henkjannl/GPS/05 Electrical/Wiring diagram 07 - MH-ET Live Minikit.jpg

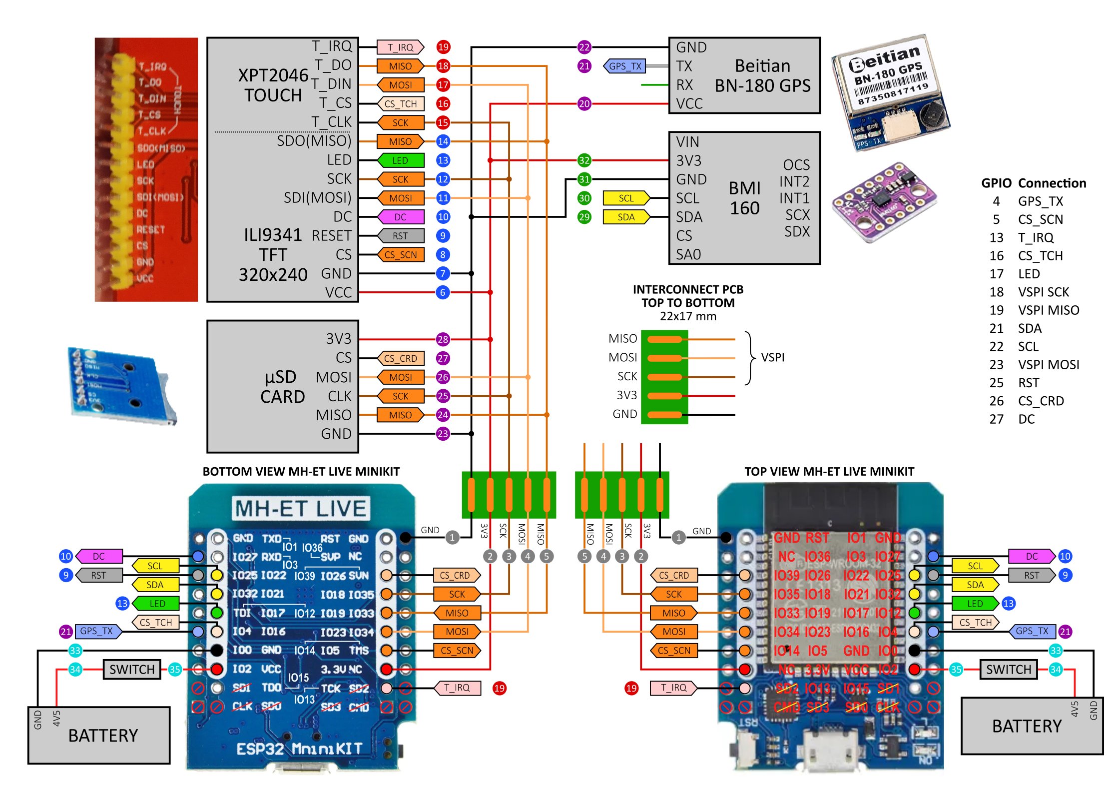
05 Electrical/Wiring diagram 07 - MH-ET Live Minikit.jpg
