henkjannl/GPS/03 Map/Kaartprojectie/Kaartprojectie.odt

# Meest nauwkeurige oplossing met kromming

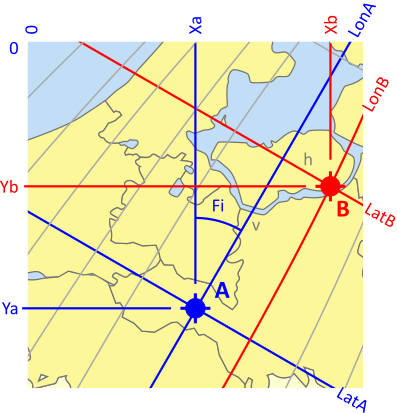
[picture p4: figure]

Punt A is de huidige positie op de kaart, behorend bij pixelpositie (xa,ya) op het scherm. De kaart moet met een hoek Fi worden verdraaid.

De omtrek van de aarde bij de parallel op latitude LatB is bij benadering:

O_{LatB}=O cdot cos(LatB) = 40 cdot 10 ^ 6 cdot cos(LatB) ~ [m]

De horizontale afstand h op het aardoppervlak is:

h_world = 40 cdot 10 ^ 6 cdot cos(LatB) cdot { {LonB-LonA} over {360}} ~ [m]

De omtrek op iedere meridiaan is bij benadering 40·10⁶ m. De vertikale afstand v op het aardoppervlak is dus:

v_world = 40 cdot 10 ^ 6 cdot { {LatB-LatA} over {360}} ~ [m]

Vaak wordt de afstand op het scherm weeregeven als een balkje dat een bepaalde lengte in werkelijkheid voorstelt. Stel een bepaalde afstand x in de werkelijke wereld correspondeert met een aantal pixels n op het scherm, dan is de schaalfactor s:

s = { n over x} ~ left [ {pixels over m} right ]

De lengte van h en v op het scherm is:

matrix{
alignl h_screen # alignl` = s cdot 40 cdot 10 ^ 6 cdot cos(LatB) cdot { alignc {LonB-LonA} over {360}} # [ pixels ] ##
alignl v_screen # alignl` = s cdot 40 cdot 10 ^ 6 cdot { alignc {LatB-LatA} over {360}} # [ pixels ] }

De schermcoördinaten van punt B zijn:

matrix{ X_B # ` = ` # X_A # `+` # v cdot sin ( Fi ) # `+` # h cdot cos ( Fi ) ##
Y_B # `=` # Y_A # `-` # v cdot cos(Fi ) # `+` # h cdot sin( Fi )

}

We definiëren hulpvariabele S:

S={alignc 40 cdot 10 ^ 6 } over {alignc 360 } cdot s {alignc 40 cdot 10 ^ 6 cdot n } over {alignc 360 cdot x }

Waarmee we de schermcoördinaten kunnen uitschrijven tot:

alignl matrix{
X_B # ` = ` # X_A # `+` # alignl S cdot lbrace { `+ (LatB-LatA) cdot sin ( Fi ) + ( alignc {LonB-LonA} )cdot cos(LatB) cdot cos ( Fi )} rbrace ##
Y_B # `=` # Y_A # `+` # alignl S cdot [ -(LatB-LatA) cdot cos(Fi ) + ( alignc {LonB-LonA} )cdot cos(LatB) cdot sin( Fi ) ]
}

We introduceren twee nieuwe hulpvariabelen:

matrix {
P # `=` # S cdot sin(Fi) # `=` # {alignc 40 cdot 10 ^ 6 cdot n} over {alignc 360 cdot x } cdot sin(Fi) ##
Q # `=` # S cdot cos(Fi) # `=` # {alignc 40 cdot 10 ^ 6 cdot n} over {alignc 360 cdot x } cdot cos(Fi)
}

Als LonB en LatB en cos(LatB) de enige variabelen over een puntenwolk zijn, dan kan dit worden omgeschreven tot:

alignl matrix{
X_B # ` = ` # X_A + S cdot sin(Fi) cdot (LatB-LatA) + S cdot cos(Fi) cdot (LonB-LonA) cdot cos(LatB) ##
X_B # ` = ` # X_A + P cdot (LatB-LatA) + Q cdot (LonB-LonA) cdot cos(LatB) ##
X_B # ` = ` # X_A + P cdot LatB- P cdot LatA + Q cdot LonB cdot cos(LatB) - Q cdot LonA cdot cos(LatB) ##
X_B # ` = ` # (X_A - P cdot LatA) + P cdot LatB - (Q cdot LonA) cdot cos(LatB)+ Q cdot LonB cdot cos(LatB) }

en:

alignl matrix{
Y_B # `=` # Y_A - S cdot cos(Fi) cdot (LatB-LatA) + S cdot sin(Fi) cdot (LonB-LonA ) cdot cos(LatB) ##
Y_B # `=` # Y_A - Q cdot (LatB-LatA) + P cdot (LonB-LonA ) cdot cos(LatB) ##
Y_B # `=` # Y_A - Q cdot LatB+ Q cdot LatA + P cdot LonB cdot cos(LatB) - P cdot LonA cdot cos(LatB) ##
Y_B # `=` # (Y_A + Q cdot LatA) - Q cdot LatB - (P cdot LonA) cdot cos(LatB)+ P cdot LonB cdot cos(LatB) }

In matrixnotatie:

left lbrace matrix { X_B ## Y_B } right rbrace =
left [
matrix {
X_A-P cdot LatA # P # -Q cdot LonA # Q ##
Y_A+Q cdot LatA # -Q # -P cdot LonA # P
}
right ] cdot
left lbrace matrix {
1 ##
LatB ##
cos(LatB) ##
LonB cdot cos(LatB) } right rbrace

# Vereenvoudigde oplossing zonder kruistermen

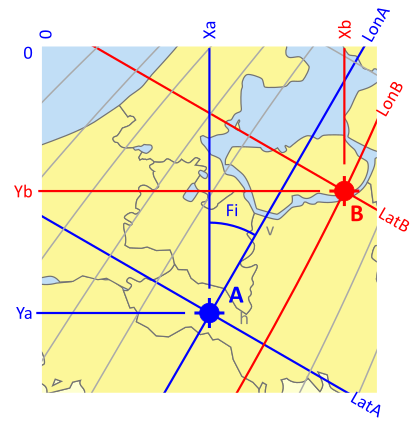
[picture p5: figure]

De horizontale afstand h op het aardoppervlak meten we hier bij punt A, zodat kruistermen worden voorkomen:

h_world = 40 cdot 10 ^ 6 cdot cos(LatA) cdot { {LonB-LonA} over {360}} ~ [m]

Bij deze benadering lopen de meridianen in de projectie dus parallel aan elkaar.

De vertikale afstand v op het aardoppervlak is ook hier:

v_world = 40 cdot 10 ^ 6 cdot { {LatB-LatA} over {360}} ~ [m]

De lengte van h en v op het scherm is:

matrix{
alignl h_screen # alignl` = s cdot 40 cdot 10 ^ 6 cdot cos(LatA) cdot { alignc {LonB-LonA} over {360}} # [ m] ##
alignl v_screen # alignl` = s cdot 40 cdot 10 ^ 6 cdot { alignc {LatB-LatA} over {360}} # [ m] }

Dezelfde afstanden gemeten in pixels:

matrix{
alignl h_pixels # alignl` = {alignc 40 cdot 10 ^ 6 cdot s} over {alignc 360 cdot m } cdot ( alignc {LonB-LonA} )cdot cos(LatA) # [ pixels ] ##
alignl v_pixels # alignl` = {alignc 40 cdot 10 ^ 6 cdot s} over {alignc 360 cdot m } cdot (LatB-LatA) # [ pixels ] }

De schermcoördinaten van punt B zijn:

matrix{ X_B # ` = ` # X_A # `+` # v cdot sin ( Fi ) # `+` # h cdot cos ( Fi ) ##
Y_B # `=` # Y_A # `-` # v cdot cos(Fi ) # `+` # h cdot sin( Fi )

}

We definiëren hulpvariabele S:

S={alignc 40 cdot 10 ^ 6 } over {alignc 360 } cdot s

Waarmee we de schermcoördinaten kunnen uitschrijven tot:

alignl matrix{
X_B # ` = ` # X_A # `+` # alignl S cdot lbrace { `+ (LatB-LatA) cdot sin ( Fi ) + ( alignc {LonB-LonA} )cdot cos(LatA) cdot cos ( Fi )} rbrace ##
Y_B # `=` # Y_A # `+` # alignl S cdot lbrace -(LatB-LatA) cdot cos(Fi ) + ( alignc {LonB-LonA} )cdot cos(LatA) cdot sin( Fi ) rbrace
}

We introduceren twee nieuwe hulpvariabelen:

matrix {
P # `=` # S cdot sin(Fi) # `=` # {alignc 40 cdot 10 ^ 6 cdot s} over {alignc 360 } cdot sin(Fi) ##
Q # `=` # S cdot cos(Fi) # `=` # {alignc 40 cdot 10 ^ 6 cdot s} over {alignc 360 } cdot cos(Fi)
}

Daarmee laten de schermcoördinaten zich omschrijven tot:

alignl matrix{
X_B # ` = ` # X_A + S cdot sin(Fi) cdot(LatB-LatA) + S cdot cos(Fi) cdot cos(LatA) cdot (LonB-LonA) ##
X_B # ` = ` # X_A + P cdot(LatB-LatA) + Q cdot cos(LatA) cdot (LonB-LonA) ##
X_B # ` = ` # [X_A - P cdot LatA - Q cdot cos(LatA) cdot LonA ]+ [P] cdot LatB + [Q cdot cos(LatA)] cdot LonB
}

alignl matrix{
Y_B # `=` # Y_A -S cdot cos(Fi) cdot(LatB-LatA) + S cdot sin(Fi) cdot cos(LatA) cdot(LonB-LonA) ##
Y_B # `=` # Y_A -Q cdot(LatB-LatA) + P cdot cos(LatA) cdot(LonB-LonA) ##
Y_B # `=` # [Y_A+Q cdot LatA- P cdot cos(LatA) cdot LonA] -Q cdot LatB + [P cdot cos(LatA)] cdot LonB

}

Oftewel:

left lbrace matrix { X_B ## Y_B } right rbrace =
left [ matrix{
X_A - P cdot LatA - Q cdot cos(LatA) cdot LonA #
Y_A + Q cdot LatA - P cdot cos(LatA) cdot LonA
##
P # -Q ##
Q cdot cos(LatA) # P cdot cos(LatA)
}
right ]
cdot left lbrace matrix { 1 ## LatB ## LonB } right rbrace

left lbrace matrix { c_1 ## c_2 ## c_3 ## c_4 ## c_5 ## c_6 } right rbrace =
left lbrace matrix { X_A - P cdot LatA - Q cdot cos(LatA) cdot LonA ##
P ##
Q cdot cos(LatA) ##
Y_A + Q cdot LatA - P cdot cos(LatA) cdot LonA ##
-Q ##
P cdot cos(LatA)
} right rbrace

left lbrace matrix { X_B ## Y_B } right rbrace =
left lbrace matrix {
c_1 + c_2 cdot LatB + c_3 cdot LonB ##
c_4 + c_5 cdot LatB + c_6 cdot LonB
} right rbrace

class MapProjection {

public:

MapProjection();

void setCenterPointOnMap(double lon, double lat);

void setCenterOnScreen(int x, int y);

void setRotation(doulbe rotation);

void setScale(int pixelsOnScreen, float distanceInWorld);

protected:

double _CenterPointOnMapLat, _CenterPointOnMapLon;

double _scale, _rotation;

int _CenterOnScreenX, _CenterOnScreenY;

double _c1, _c2, _c3, _c4, _c5, _c6;

MapProjection::CalcScale() {

double P=40e6*_scale/360*sin(_rotation)

double Q=40e6*_scale/360*cos(_rotation)

_c1=_CenterOnScreenX-P*_CenterPointOnMapLat-Q*cos(radians(_CenterPointOnMapLat))*_CenterPointOnMapLon;

_c2=P;

_c3=Q*cos(radians(_CenterPointOnMapLat));

_c4=_CenterOnScreenY+Q*_CenterPointOnMapLat-P*cos(radians(_CenterPointOnMapLat))*_CenterPointOnMapLon;

_c5=-Q;

_c6=P*cos(radians(_CenterPointOnMapLat));

}

# Vergelijking

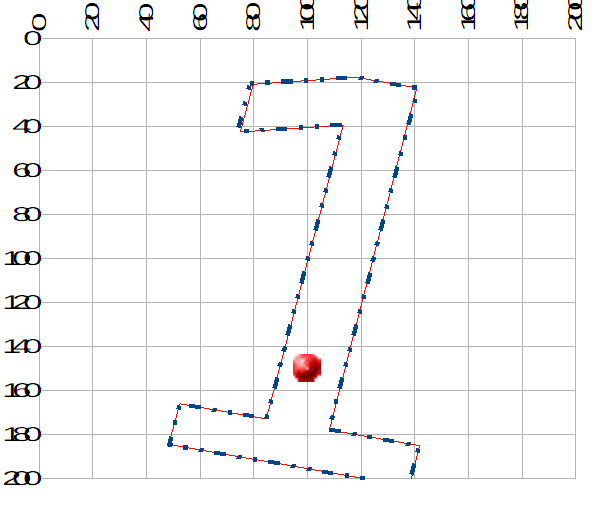
[picture p6: figure]

Als we beide projectiemethoden vergelijken met een testpatroon van ongeveer 200 km hoog is het verschil minder dan een pixel. Bij grote breedtegraad (ver boven Stockholm) wordt dit iets meer dan een pixel. De eenvoudige projectiemethode is dus goed bruikbaar voor een fiets-GPS.

Voor grotere afbeeldingen is de nauwkeuriger projectiemethode meer geschikt.

# Gebruikt testpatroon:

LatB | LonB
53.10 | 4.80
53.20 | 5.35
53.20 | 5.70
51.77 | 5.70
51.77 | 6.20
51.60 | 6.20
51.60 | 4.87
51.77 | 4.87
51.77 | 5.35
53.00 | 5.35
52.90 | 4.80
53.10 | 4.80
