henkjannl/GPS/04 GUI/Only map 320x240.png

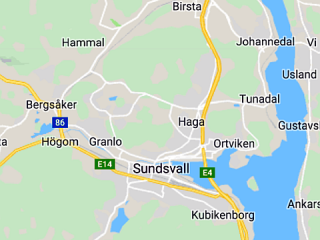
04 GUI/Only map 320x240.png
