henkjannl/GPS/05 Electrical/Connect ili9341.png

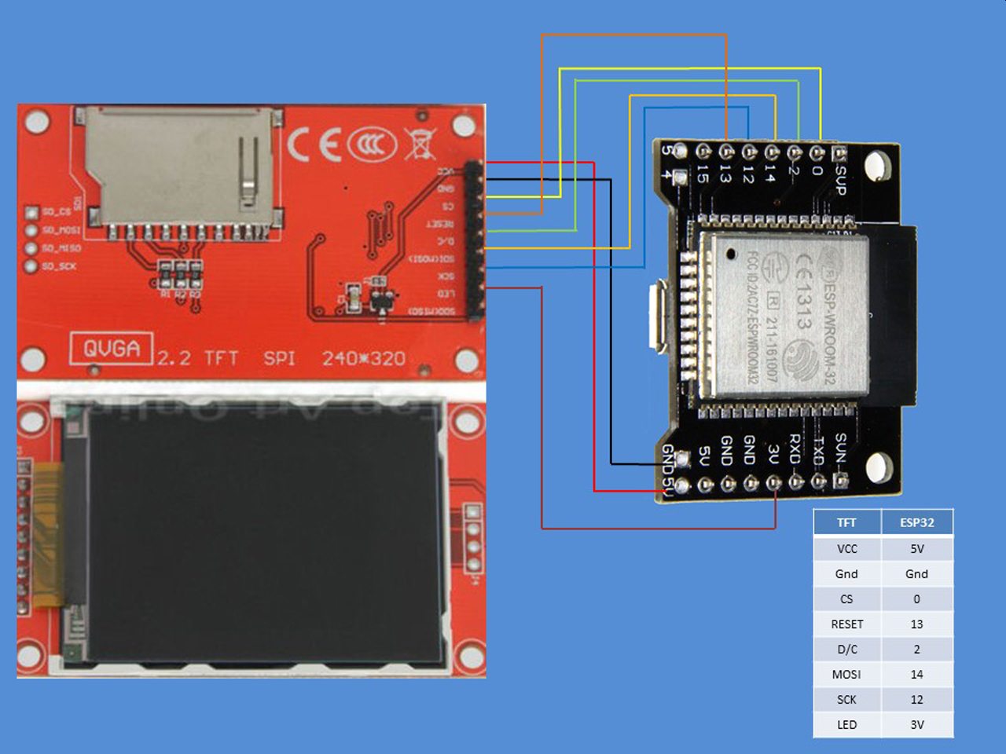
05 Electrical/Connect ili9341.png
