henkjannl/GPS/07 Software/_Feasibility/GPGGA.png

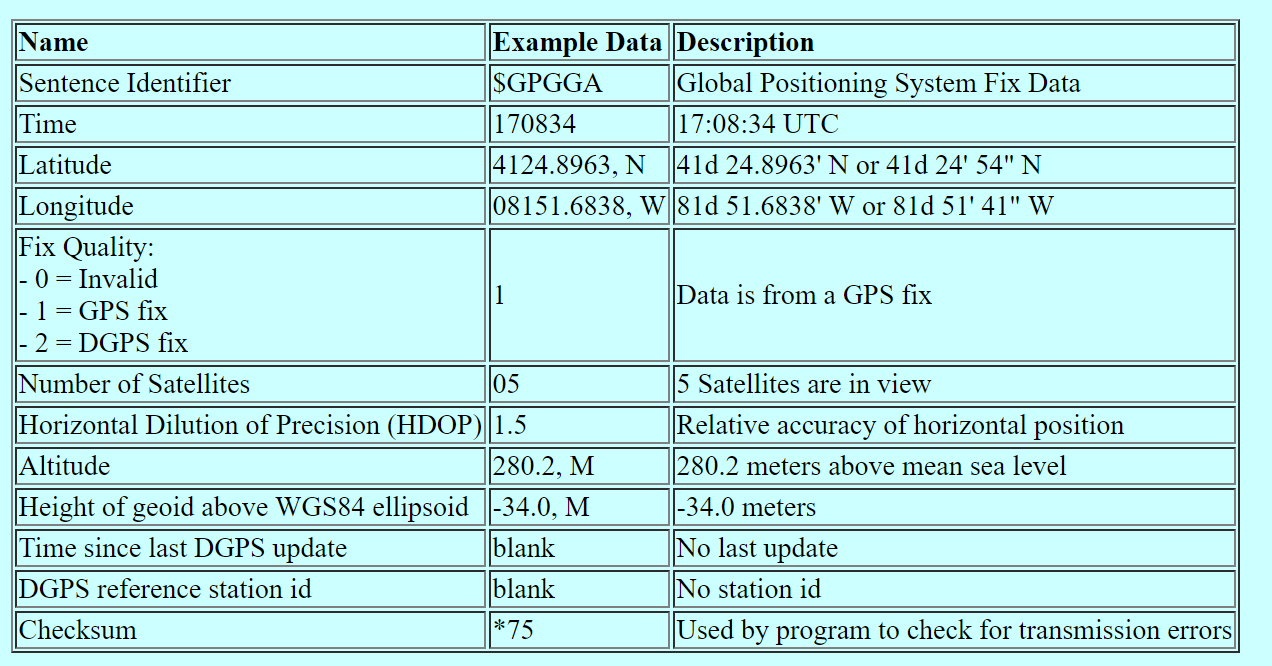
07 Software/_Feasibility/GPGGA.png
