henkjannl/GPS/08 Documentation/Bresenham/A.S.Murphy - Line thickening by modification to Bresenham's algorithm/tlalgp5.gif

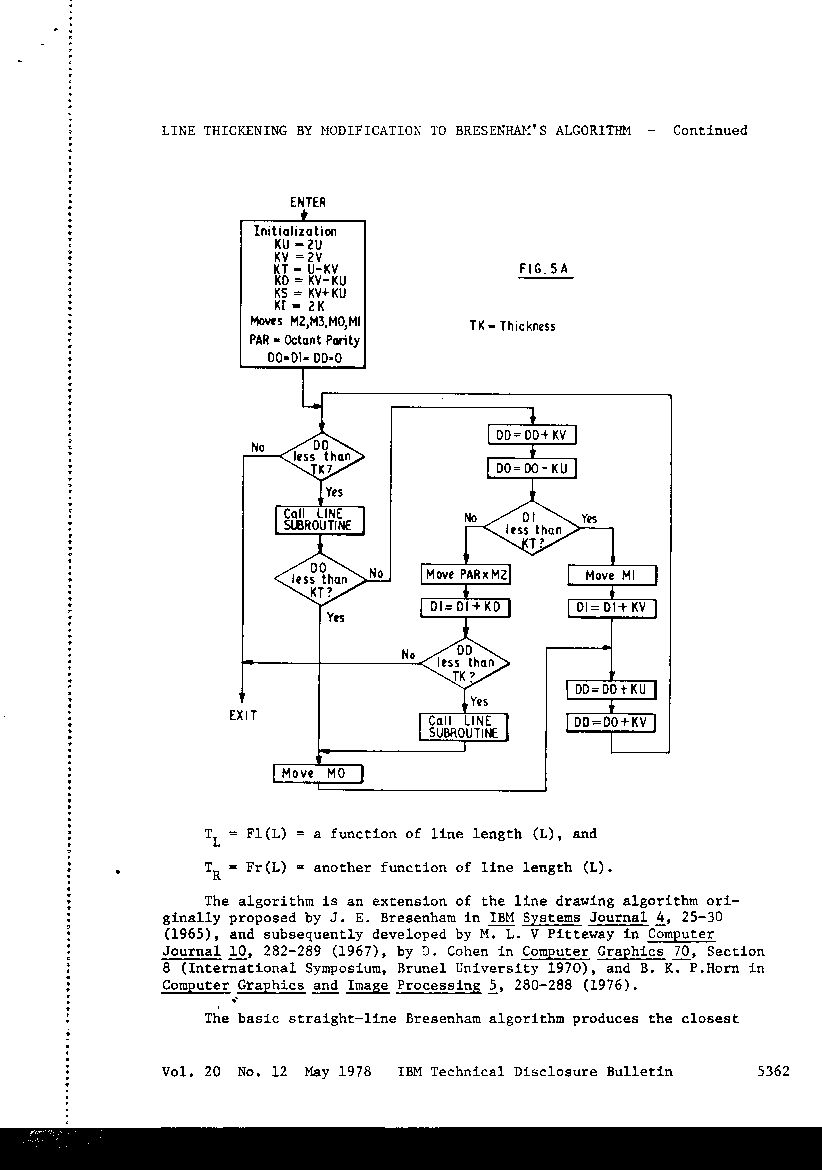
08 Documentation/Bresenham/A.S.Murphy - Line thickening by modification to Bresenham's algorithm/tlalgp5.gif
