henkjannl/GPS/09 Readonly/MapCoordinates.png

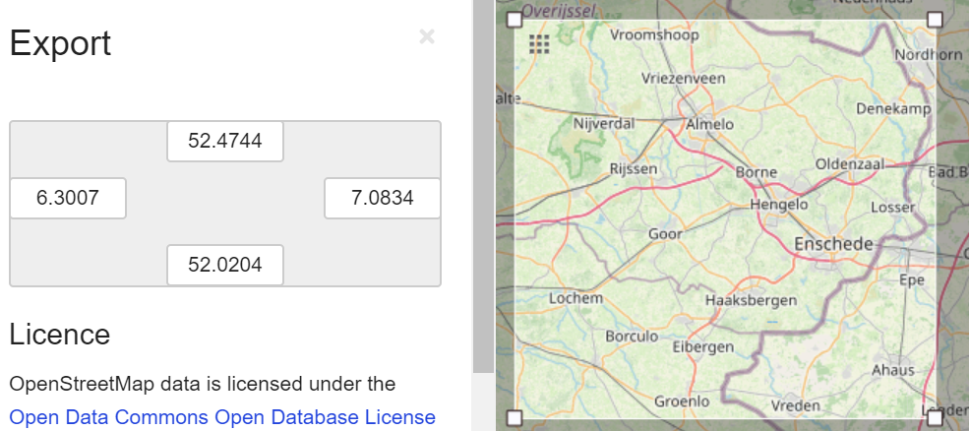
09 Readonly/MapCoordinates.png
