henkjannl/GPS/09 Readonly/MapCoordinatesTwente.png

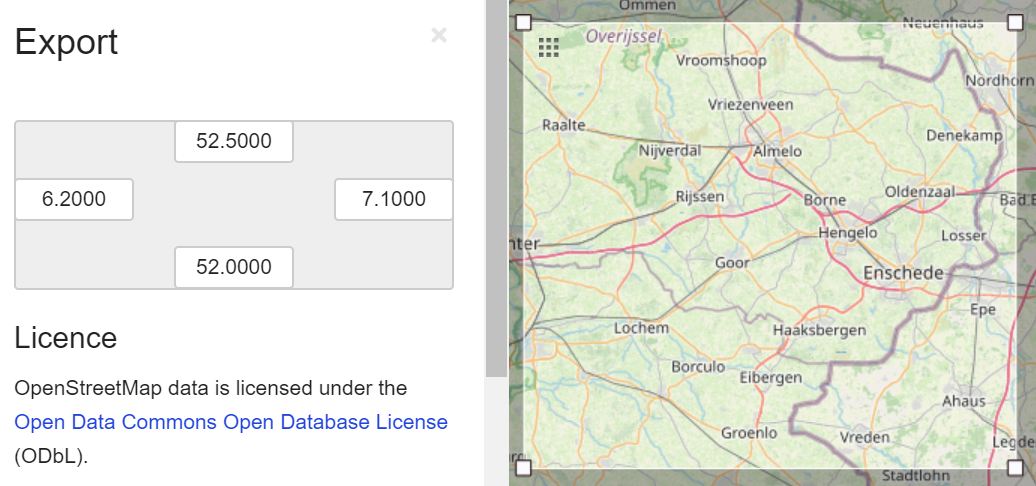
09 Readonly/MapCoordinatesTwente.png
