henkjannl/GPS/01 Project management/Project management and system design.ods

Sheet: Todo
Task |  | V0.01 | V0.02 | V0.03 | V0.04 | V0.05 | V0.06 | V0.07 | V0.08 | V0.09 | V0.10 | V0.11 | V0.12 | V1.0 | V1.01 | V2.0 | V2.01 | V3.0 | V4.0 | V5.0 | V6.0 | V7.0 | V8.0 | Overall progress: 24%
 |  | 100% | 86% | 25% | 34% | 0% | 0% | 0% | 0% | 8% | 0% | 0% | 0% | 0% | 11% | 0% | 0% | 0% | 0% | 0% | 0% | 0% | 0%
V0.01 System design
 | Setup programming environment for ESP32 | 100%
 | Find out how I²C works | 100%
 | Control screen with driver and I²C | 100%
 | Write routine to draw lines with variable width | 100%
 | Make connection diagram for ESP and check free GPIO | 100%
 | Find out how UART works | 100%
 | Implement NMEA 0183 parser | 100%
 | Find out how GPS module works | 100%
 | Find out how SPI works | 100%
 | Writing to and reading from SD Card | 100%
 | Work out map projection | 100%
 | Connect and test 320x240 color screen via SPI | 100%
 | Connect and test XPT2046 touch screen via SPI | 100%
 | Study Doxygen |  |  |  |  |  | 0%
V0.02 Develop hardware
 | Find out how to connect touch screen |  | 100%
 | Find out how to connect GPS |  | 100%
 | Find out how to connect inertial measurement unit (IMU) |  | 100%
 | Find out how to connect SD Card |  | 100%
 | Develop case |  | 100%
 | Connect everything |  | 100%
 | Find out how to use SD Card and screen simultaneously |  | 0%
V0.03 First screens
 | Develop GUI library |  |  | 50%
 | Develop screens |  |  | 0%
V0.04 Develop and implement basic version
 | Update knowledge of C/C++ language |  |  |  | 30%
 | Install ESP-IDF and toolchain |  |  |  | 100%
 | Study coding styles an choose one |  |  |  |  |  | 0%
 | Choose right containers in C++ to store data |  |  |  | 0%
 | Choose graphics/GUI library |  |  |  | 100%
 | First simple GUI design |  |  |  | 0%
 | Data in hardcoded structure |  |  |  | 80%
 | Translate GPS coordinates in XY coordinates |  |  |  | 0%
 | Learn how to render simple map, just roads |  |  |  | 0%
V0.05 Rotate and zoom
 | Implement rotate and zoom, for virtual path from GPS |  |  |  |  | 0%
V0.06 Labels
 | Write text labels next to cities, at fixed locations on the map |  |  |  |  |  | 0%
V0.07 Connect GPS
 | Check if we can also write settings (e.g. polling frequency) to GPS |  |  |  |  |  |  | 0%
 | Log data to SD card |  |  |  |  |  |  | 0%
 | Filter data so location and course are reliable |  |  |  |  |  |  | 0%
 | Hook up location and course to rendering engine |  |  |  |  |  |  | 0%
V0.08 Implement rendering of thick lines
 | Separate two data sources: map and route |  |  |  |  |  |  |  | 0%
 | Store planned track on SD card |  |  |  |  |  |  |  | 0%
 | Read planned track from SD card |  |  |  |  |  |  |  | 0%
 | Draw route in different thickness and color to enhance contrast |  |  |  |  |  |  |  | 0%
V0.09 Include charge circuit
 | Include charge circuit, mains switch and battery |  |  |  |  |  |  |  |  | 0%
 | Don’t forget hardware button to prevent full discharge |  |  |  |  |  |  |  |  | 0%
 | Check how to work with rechargeable battery |  |  |  |  |  |  |  |  | 0%
 | Order and connect rechargeable battery |  |  |  |  |  |  |  |  | 50%
 | Test interrupt with or without pull up on breadboard |  |  |  |  |  |  |  |  | 0%
V0.10 Power management
 | Measure power consumption |  |  |  |  |  |  |  |  |  | 0%
 | Check if power drops if we touch of screen |  |  |  |  |  |  |  |  |  | 0%
 | Check if power drops if we go to deep power |  |  |  |  |  |  |  |  |  | 0%
 | Consider alternative circuitry |  |  |  |  |  |  |  |  |  | 0%
V0.11 Battery level indicator
 | Connect hardware |  |  |  |  |  |  |  |  |  |  | 0%
 | Measure full charge cycle |  |  |  |  |  |  |  |  |  |  | 0%
 | Implement |  |  |  |  |  |  |  |  |  |  | 0%
V0.12 Finalize hardware
 | Choose PCB software (Fritzing, Easy PCB, Online tool) |  |  |  |  |  |  |  |  |  |  |  | 0%
 | Investigate how to design PCB |  |  |  |  |  |  |  |  |  |  |  | 0%
 | Draw missing components |  |  |  |  |  |  |  |  |  |  |  | 0%
 | Port breadboard solution to soldered solution |  |  |  |  |  |  |  |  |  |  |  | 0%
 | Solder everything and complete mechanical design |  |  |  |  |  |  |  |  |  |  |  | 0%
V1.0 Improve map
 | Separate map in tiles |  |  |  |  |  |  |  |  |  |  |  |  | 0%
 | Parse open streetmap files and write to tiles |  |  |  |  |  |  |  |  |  |  |  |  | 0%
 | Determine how large tiles should be to fit memory |  |  |  |  |  |  |  |  |  |  |  |  | 0%
 | Read tiles in device |  |  |  |  |  |  |  |  |  |  |  |  | 0%
 | Build up map based on tiles |  |  |  |  |  |  |  |  |  |  |  |  | 0%
V1.01 Improve GUI
 | Calculate and display speed and distance to come |  |  |  |  |  |  |  |  |  |  |  |  |  | 0%
 | Study Garmin user manual for ideas |  |  |  |  |  |  |  |  |  |  |  |  |  | 50%
 | Develop screens |  |  |  |  |  |  |  |  |  |  |  |  |  | 10%
 | Select GUI library |  |  |  |  |  |  |  |  |  |  |  |  |  | 50%
 | Test GUI library |  |  |  |  |  |  |  |  |  |  |  |  |  | 0%
 | Learn how to quickly create many buttons |  |  |  |  |  |  |  |  |  |  |  |  |  | 0%
 | Learn how to switch screens |  |  |  |  |  |  |  |  |  |  |  |  |  | 0%
 | Implement screen and menu structure |  |  |  |  |  |  |  |  |  |  |  |  |  | 0%
 | Display current location with sprite |  |  |  |  |  |  |  |  |  |  |  |  |  | 0%
V2.00: Store and retrieve trip data
 | Use GPS time to set the real time clock |  |  |  |  |  |  |  |  |  |  |  |  |  |  | 0%
 | Log current track to SDcard |  |  |  |  |  |  |  |  |  |  |  |  |  |  | 0%
V2.01: See if accelerometer helps for fine resolution
 | Connect hardware module |  |  |  |  |  |  |  |  |  |  |  |  |  |  |  | 0%
 | Log sample data |  |  |  |  |  |  |  |  |  |  |  |  |  |  |  | 0%
 | Filter data so location and course are reliable |  |  |  |  |  |  |  |  |  |  |  |  |  |  |  | 0%
V3: Add trip computer
 | Retrieve list of actual log data for test purposes |  |  |  |  |  |  |  |  |  |  |  |  |  |  |  |  | 0%
 | Calculate accurate location |  |  |  |  |  |  |  |  |  |  |  |  |  |  |  |  | 0%
 | Calculate distance travelled |  |  |  |  |  |  |  |  |  |  |  |  |  |  |  |  | 0%
 | Calculate accurate distance to come |  |  |  |  |  |  |  |  |  |  |  |  |  |  |  |  | 0%
 | Calculate other data (average speed, etc) |  |  |  |  |  |  |  |  |  |  |  |  |  |  |  |  | 0%
 | Design and implement trip computer window |  |  |  |  |  |  |  |  |  |  |  |  |  |  |  |  | 0%
V4: Store and select a list of waypoints
 | Create a list of waypoints |  |  |  |  |  |  |  |  |  |  |  |  |  |  |  |  |  | 0%
 | Create a window to select a waypoint |  |  |  |  |  |  |  |  |  |  |  |  |  |  |  |  |  | 0%
 | Draw a line to the selected waypoint |  |  |  |  |  |  |  |  |  |  |  |  |  |  |  |  |  | 0%
 | Compute the distance left |  |  |  |  |  |  |  |  |  |  |  |  |  |  |  |  |  | 0%
V5: Map
 | Download OSM map of the Netherlands |  |  |  |  |  |  |  |  |  |  |  |  |  |  |  |  |  |  | 0% |  |  |  | http://download.geofabrik.de/europe/netherlands.html
 | Find toolchain to parse and render map (offline/embedded) |  |  |  |  |  |  |  |  |  |  |  |  |  |  |  |  |  |  | 0%
 | Download and translate map data to device |  |  |  |  |  |  |  |  |  |  |  |  |  |  |  |  |  |  | 0%
 | Work out how to dynamically load relevant tiles |  |  |  |  |  |  |  |  |  |  |  |  |  |  |  |  |  |  | 0%
 | Display map with zooming and rotation |  |  |  |  |  |  |  |  |  |  |  |  |  |  |  |  |  |  | 0%
V6: Routing
 | Also retrieve a graph with routing data |  |  |  |  |  |  |  |  |  |  |  |  |  |  |  |  |  |  |  | 0%
 | Analyze and recognize types of junctions |  |  |  |  |  |  |  |  |  |  |  |  |  |  |  |  |  |  |  | 0%
 | Prepare intelligent instructions on the road |  |  |  |  |  |  |  |  |  |  |  |  |  |  |  |  |  |  |  | 0%
 | Add to the program |  |  |  |  |  |  |  |  |  |  |  |  |  |  |  |  |  |  |  | 0%
V7: Advanced power, WiFi
 | Find out how to implement on/off functionality with deep sleep |  |  |  |  |  |  |  |  |  |  |  |  |  |  |  |  |  |  |  |  | 0%
V8: WiFi
 | Implement WiFi connection |  |  |  |  |  |  |  |  |  |  |  |  |  |  |  |  |  |  |  |  |  | 0%
 | Load and save files to and from the SD card over WiFi |  |  |  |  |  |  |  |  |  |  |  |  |  |  |  |  |  |  |  |  |  | 0%
 | Make desktop app to exchange waypoints, tracks, trips and maps |  |  |  |  |  |  |  |  |  |  |  |  |  |  |  |  |  |  |  |  |  | 0%
 |  | 0% | 0% | 0% | 0% | 0% | 0% | 0% | 0% | 0% | 0% | 0% | 0% | 0% | 0% | 0% | 0% | 0% | 0% | 0% | 0% | 0% | 0%
 |  | 100% | 100% | 100% | 100% | 100% | 100% | 100% | 100% | 100% | 100% | 100% | 100% | 100% | 100% | 100% | 100% | 100% | 100% | 100% | 100% | 100% | 100%

Sheet: Risks
Risk | Assessment | Mitigations
Power consumption too high | Seems to be OK, see sheet ‘Battery capacity’ | Sleep mode etc.
 |  | More efficient GPS
 |  | Switchable GPS?
 |  | Turn screen off
 |  | Larger batteries
Too little RAM | Seems to be OK, 350k left when loading simple GUI
Too little processing power | Seems to be OK, since TomTom released working systems in 2001, probably with less potent hardware

Sheet: Bill of materials
Item | Number | Item name | Brand, type | Price | Ordering information
1 | 1 | Housing top | PETG | € 0.99
2 | 1 | Housing bottom | PETG | € 0.98
3 | 1 | Battery door | PETG | € 0.35
4 | 1 | Mount for screen | PETG | € 0.29
5 | 1 | Mount for GPS | PETG | € 0.02
6 | 1 | Interconnect PCB | Pitch 2.54 mm. Size 17.5 x 22 mm. Tracks along long side | € 0.28 | https://www.aliexpress.com/item/1005001320996968.html?spm=2114.12010612.8148356.37.41a84678MVd4LE
7 | 1 | EPS32 board | MN-EH Live ESP32 Minikit | € 2.99 | https://www.aliexpress.com/item/4000232057013.html?spm=a2g0s.9042311.0.0.27424c4dUEGiZK
8 | 1 | Touch screen | 3.2” TFT 320x240 SPI, ILI9341, red PCB | € 8.31 | https://www.aliexpress.com/item/32911859963.html?spm=a2g0s.9042311.0.0.27424c4diYw1pe
9 | 1 | GPS module | Beitan BN-180 GPS | € 8.29 | https://www.aliexpress.com/item/32796866720.html?spm=a2g0s.9042311.0.0.27424c4d6ImvZa
10 | 1 | Accelerometer | BMI-160 | € 1.55 | https://www.aliexpress.com/item/32701667120.html?spm=a2g0s.9042311.0.0.27424c4dZzrM2J
11 | 1 | SD Card reader |  | € 0.50 | https://www.aliexpress.com/item/32673631024.html?spm=a2g0s.9042311.0.0.27424c4dL440tU
12 | 1 | Rocker switch | KCD1-11 | € 0.16 | https://www.aliexpress.com/item/32914563080.html
13 | 1 | Battery compartment | 3xAAA | € 0.44 | https://www.aliexpress.com/item/32839060486.html?spm=a2g0s.9042311.0.0.27424c4dUEGiZK
14 | 6 | Screws housing | 3.0 x 16 mm | € 0.01 | https://www.aliexpress.com/item/4001014535120.html?spm=a2g0s.9042311.0.0.27424c4d9eWR4X
15 | 4 | Screws screen | 2.6 x 12 mm | € 0.01 | https://www.aliexpress.com/item/4001014535120.html?spm=a2g0s.9042311.0.0.27424c4d9eWR4X
16 | 1 | Screw GPS | 2.6 x 12 mm | € 0.01 | https://www.aliexpress.com/item/4001014535120.html?spm=a2g0s.9042311.0.0.27424c4d9eWR4X
17 | 1 | Screw battery door | M3x8 | € 0.03 | https://www.aliexpress.com/item/4000784829771.html?spm=2114.12010615.8148356.12.1bd247ad3bVaoZ
 |  |  |  | € 25.34

Sheet: Battery capacity
Measured current, with GPS | 140 | mA
Measured current, without GPS | 100 | mA
Capacity alkaline AAA LR03, min | 860 | mAh
Capacity alkaline AAA LR03, max | 1200 | mAh
Number of batteries | 3
Total battery capacity, min | 2580 | mAh
Total battery capacity, max | 3600 | mAh
Total battery time, min | 18.4285714285714 | h
Total battery time, max | 25.7142857142857 | h
Measured with screen on, no WiFi, no power management on ESP

Sheet: MapStructure
node
street |  |  | Street Object
 | name |  | Name of the street
 | sections |  | Sections of the street
 |  | points | Points in each section

Sheet: TTGO-T1
Pin No. | Use in GPS project | Pin Name | Pin Name | Pin Name | Power Domain | AnalogFunction1 | AnalogFunction2 | AnalogFunction3 | RTC_GPIO | Function1 | Type | Function2 | Type | Function3 | Type | Function4 | Type | Function5 | Type | Function6 | Type | Drive Strength (2’d2: 24mA) | At Reset | After Reset
0
1 |  | VDDA |  |  | VANA in
2 |  |  | LNA_IN |  | VANA in
3 |  | VDD3P3 |  |  | VANA in
4 |  | VDD3P3 |  |  | VANA in
5 |  |  | SENSOR_VP |  | VRTC | ADC_H | ADC1_CH0 |  | RTC_GPIO0 | GPIO36 | I |  |  | GPIO36 | I |  |  |  |  |  |  |  |  | ie=0
6 |  |  | SENSOR_CAPP |  | VRTC | ADC_H | ADC1_CH1 |  | RTC_GPIO1 | GPIO37 | I |  |  | GPIO37 | I |  |  |  |  |  |  |  |  | ie=0
7 |  |  | SENSOR_CAPN |  | VRTC | ADC_H | ADC1_CH2 |  | RTC_GPIO2 | GPIO38 | I |  |  | GPIO38 | I |  |  |  |  |  |  |  |  | ie=0
8 |  |  | SENSOR_VN |  | VRTC | ADC_H | ADC1_CH3 |  | RTC_GPIO3 | GPIO39 | I |  |  | GPIO39 | I |  |  |  |  |  |  |  |  | ie=0
9 |  |  | CHIP_PU |  | VRTC
10 |  |  | VDET_1 |  | VRTC |  | ADC1_CH6 |  | RTC_GPIO4 | GPIO34 | I |  |  | GPIO34 | I |  |  |  |  |  |  |  |  | ie=0
11 |  |  | VDET_2 |  | VRTC |  | ADC1_CH7 |  | RTC_GPIO5 | GPIO35 | I |  |  | GPIO35 | I |  |  |  |  |  |  |  |  | ie=0
12 | Backlight BL (ILI9341) |  | 32K_XP |  | VRTC | XTAL_32K_P | ADC1_CH4 | TOUCH9 | RTC_GPIO9 | GPIO32 | I/O/T |  |  | GPIO32 | I/O/T |  |  |  |  |  |  | 2'd2 |  | ie=0
13 |  |  | 32K_XN |  | VRTC | XTAL_32K_N | ADC1_CH5 | TOUCH8 | RTC_GPIO8 | GPIO33 | I/O/T |  |  | GPIO33 | I/O/T |  |  |  |  |  |  | 2'd2 |  | ie=0
14 |  |  |  | GPIO25 | VRTC | DAC_1 | ADC2_CH8 |  | RTC_GPIO6 | GPIO25 | I/O/T |  |  | GPIO25 | I/O/T |  |  |  |  | EMAC_RXD0 | I | 2'd2 |  | ie=0
15 |  |  |  | GPIO26 | VRTC | DAC_2 | ADC2_CH9 |  | RTC_GPIO7 | GPIO26 | I/O/T |  |  | GPIO26 | I/O/T |  |  |  |  | EMAC_RXD1 | I | 2'd2 |  | ie=0
16 |  |  |  | GPIO27 | VRTC |  | ADC2_CH7 | TOUCH7 | RTC_GPIO17 | GPIO27 | I/O/T |  |  | GPIO27 | I/O/T |  |  |  |  | EMAC_RX_DV | I | 2'd2 |  | ie=1
17 | SD Card SCK |  |  | MTMS | VRTC |  | ADC2_CH6 | TOUCH6 | RTC_GPIO16 | MTMS | I0 | HSPICLK | I/O/T | GPIO14 | I/O/T | HS2_CLK | O | SD_CLK | I0 | EMAC_TXD2 | O | 2'd2 |  | ie=1
18 |  |  |  | MTDI | VRTC |  | ADC2_CH5 | TOUCH5 | RTC_GPIO15 | MTDI | I1 | HSPIQ | I/O/T | GPIO12 | I/O/T | HS2_DATA2 | I1/O/T | SD_DATA2 | I1/O/T | EMAC_TXD3 | O | 2'd2 | wpd, ie=1 | wpd, ie=1
19 |  | VDD3P3_RTC |  |  | VRTC supply in
20 | SD Card CS |  |  | MTCK | VRTC |  | ADC2_CH4 | TOUCH4 | RTC_GPIO14 | MTCK | I1 | HSPID | I/O/T | GPIO13 | I/O/T | HS2_DATA3 | I1/O/T | SD_DATA3 | I1/O/T | EMAC_RX_ER | I | 2'd2 |  | ie=1
21 | SD Card MOSI |  |  | MTDO | VRTC |  | ADC2_CH3 | TOUCH3 | RTC_GPIO13 | MTDO | O/T | HSPICS0 | I/O/T | GPIO15 | I/O/T | HS2_CMD | I1/O/T | SD_CMD | I1/O/T | EMAC_RXD3 | I | 2'd2 | wpu, ie=1 | wpu, ie=1
22 | SD Card MISO |  |  | GPIO2 | VRTC |  | ADC2_CH2 | TOUCH2 | RTC_GPIO12 | GPIO2 | I/O/T | HSPIWP | I/O/T | GPIO2 | I/O/T | HS2_DATA0 | I1/O/T | SD_DATA0 | I1/O/T |  |  | 2'd2 | wpd, ie=1 | wpd ,ie=1
23 | Touch screen IRQ (T_IRQ) |  |  | GPIO0 | VRTC |  | ADC2_CH1 | TOUCH1 | RTC_GPIO11 | GPIO0 | I/O/T | CLK_OUT1 | O | GPIO0 | I/O/T |  |  |  |  | EMAC_TX_CLK | I | 2'd2 | wpu, ie=1 | wpu, ie=1
24 | RST (ILI9341) |  |  | GPIO4 | VRTC |  | ADC2_CH0 | TOUCH0 | RTC_GPIO10 | GPIO4 | I/O/T | HSPIHD | I/O/T | GPIO4 | I/O/T | HS2_DATA1 | I1/O/T | SD_DATA1 | I1/O/T | EMAC_TX_ER | O | 2'd2 | wpd, ie=1 | wpd, ie=1
 |  |  |  | GPIO20 | VSDIO |  |  |  |  | GPIO20 | I/O/T |  |  | GPIO20 | I/O/T |  |  |  |  |  |  | 2'd2 |  | ie=1
25 | GPS TX |  |  | GPIO16 | VSDIO |  |  |  |  | GPIO16 | I/O/T |  |  | GPIO16 | I/O/T | HS1_DATA4 | I1/O/T | U2RXD | I1 | EMAC_CLK_OUT | O | 2'd2 |  | ie=1
26 |  | VDD_SDIO |  |  | VSDIO supply out/in
27 | DC (ILI9341) |  |  | GPIO17 | VSDIO |  |  |  |  | GPIO17 | I/O/T |  |  | GPIO17 | I/O/T | HS1_DATA5 | I1/O/T | U2TXD | O | EMAC_CLK_OUT_180 | O | 2'd2 |  | ie=1
28 |  |  |  | SD_DATA_2 | VSDIO |  |  |  |  | SD_DATA2 | I1/O/T | SPIHD | I/O/T | GPIO9 | I/O/T | HS1_DATA2 | I1/O/T | U1RXD | I1 |  |  | 2'd2 | wpu, ie=1 | wpu, ie=1
29 |  |  |  | SD_DATA_3 | VSDIO |  |  |  |  | SD_DATA3 | I0/O/T | SPIWP | I/O/T | GPIO10 | I/O/T | HS1_DATA3 | I1/O/T | U1TXD | O |  |  | 2'd2 | wpu, ie=1 | wpu, ie=1
30 |  |  |  | SD_CMD | VSDIO |  |  |  |  | SD_CMD | I1/O/T | SPICS0 | I/O/T | GPIO11 | I/O/T | HS1_CMD | I1/O/T | U1RTS | O |  |  | 2'd2 | wpu, ie=1 | wpu, ie=1
31 |  |  |  | SD_CLK | VSDIO |  |  |  |  | SD_CLK | I0 | SPICLK | I/O/T | GPIO6 | I/O/T | HS1_CLK | O | U1CTS | I1 |  |  | 2'd2 | wpu, ie=1 | wpu, ie=1
32 |  |  |  | SD_DATA_0 | VSDIO |  |  |  |  | SD_DATA0 | I1/O/T | SPIQ | I/O/T | GPIO7 | I/O/T | HS1_DATA0 | I1/O/T | U2RTS | O |  |  | 2'd2 | wpu, ie=1 | wpu, ie=1
33 |  |  |  | SD_DATA_1 | VSDIO |  |  |  |  | SD_DATA1 | I1/O/T | SPID | I/O/T | GPIO8 | I/O/T | HS1_DATA1 | I1/O/T | U2CTS | I1 |  |  | 2'd2 | wpu, ie=1 | wpu, ie=1
34 | VSPI SS (ILI9341 & XPT2046) |  |  | GPIO5 | VIO |  |  |  |  | GPIO5 | I/O/T | VSPICS0 | I/O/T | GPIO5 | I/O/T | HS1_DATA6 | I1/O/T |  |  | EMAC_RX_CLK | I | 2'd2 | wpu, ie=1 | wpu, ie=1
35 | VSPI SCK (ILI9341 & XPT2046) |  |  | GPIO18 | VIO |  |  |  |  | GPIO18 | I/O/T | VSPICLK | I/O/T | GPIO18 | I/O/T | HS1_DATA7 | I1/O/T |  |  |  |  | 2'd2 |  | ie=1
36 | VSPI MOSI (ILI9341 & XPT2046) |  |  | GPIO23 | VIO |  |  |  |  | GPIO23 | I/O/T | VSPID | I/O/T | GPIO23 | I/O/T | HS1_STROBE | I0 |  |  |  |  | 2'd2 |  | ie=1
37 |  | VDD3P3_CPU |  |  | VIO supply in
38 | VSPI MISO (ILI9341 & XPT2046) |  |  | GPIO19 | VIO |  |  |  |  | GPIO19 | I/O/T | VSPIQ | I/O/T | GPIO19 | I/O/T | U0CTS | I1 |  |  | EMAC_TXD0 | O | 2'd2 |  | ie=1
39 |  |  |  | GPIO22 | VIO |  |  |  |  | GPIO22 | I/O/T | VSPIWP | I/O/T | GPIO22 | I/O/T | U0RTS | O |  |  | EMAC_TXD1 | O | 2'd2 |  | ie=1
40 |  |  |  | U0RXD | VIO |  |  |  |  | U0RXD | I1 | CLK_OUT2 | O | GPIO3 | I/O/T |  |  |  |  |  |  | 2'd2 | wpu, ie=1 | wpu, ie=1
41 |  |  |  | U0TXD | VIO |  |  |  |  | U0TXD | O | CLK_OUT3 | O | GPIO1 | I/O/T |  |  |  |  | EMAC_RXD2 | I | 2'd2 | wpu, ie=1 | wpu, ie=1
42 | Touchscreen chip select T_CS |  |  | GPIO21 | VIO |  |  |  |  | GPIO21 | I/O/T | VSPIHD | I/O/T | GPIO21 | I/O/T |  |  |  |  | EMAC_TX_EN | O | 2'd2 |  | ie=1
43 |  |  |  | VDDA | VANA in
44 |  |  | XTAL_N |  | VANA
45 |  |  | XTAL_P |  | VANA
46 |  | VDDA |  |  | VANA
47 |  |  | CAP2 |  | VANA
48 |  |  | CAP1 |  | VANA
Total Number |  | 8 | 14 | 26

Sheet: GUI
Screen | Short description | Buttons
 |  | Next |  | Select |  | Up |  | Down |  | Plus |  | Minus
 |  | Task | Handler | Task | Handler | Task | Handler | Task | Handler | Task | Handler | Task | Handler
scnMap | Map with some fields of data | Go to the screen with trip data | doTripScreen | * nothing * | * none * | Next set of data to be shown on the map screen | doMapNextData | Previous set of data to be shown on the map screen | doMapPrevData | Zoom in on the map | doMapZoomIn | Zoom out on the map | doMapZoomOut
scnTrip | Map with directions | Go to the menu screen | doMenuScreen | * nothing * | * none * | Next layout of trip data screen | doTripNextLayout | Previous layout of trip data screen | doTripPrevLayout | * nothing * | * none * | * nothing * | * none *
scnMenu | Just the map and nothing else | Go to the map screen | doMapScreen | Select highlighted item | doMenuSelectItem | Select previous item | doMenuItemUp | Select next item | doMenuItemDown | * nothing * | * none * | * nothing * | * none *
scnSettings
#SettingsScreen | Bring up the settings screen | #Settings

Sheet: Projection
Current location |  |  | Helper variables |  |  |  | LatB | LonB | cos(LatB) | X | Simple | Realistic | Current | Difference
LatA | 51.6 | ° | S | 83.3333333333333 |  |  | 53.1 | 4.8 | 0.600420225325884 | 53.8426355019452 | 33.7776852099787 |  |  | 0.1209107372225
LonA | 4.87 | ° | P | -28.5016786104724 |  |  | 53.2 | 5.35 | 0.599023598515586 | 77.7448336450472 | 16.2098484483905 |  |  | 0.884967270508991
 |  |  | Q | 78.3077183988257 |  |  | 53.2 | 5.7 | 0.599023598515586 | 94.7690665567785 | 10.0135344073052 |  |  | 1.5302559052551
Current location on screen |  |  |  |  |  |  | 51.77 | 5.7 | 0.61881978427573 | 135.526466969754 | 121.993571717626 |  |  | 0.16101972351177
Xa | 100 | pix | Simple projection |  | Realistic projection |  | 51.77 | 6.2 | 0.61881978427573 | 159.846799700799 | 113.141694516076 |  |  | 0.258019556952542
Ya | 150 | pix | 1333.8065755 | 4276.89555332251 | 1570.68661630038 | 4190.67826937941 | 51.6 | 6.2 | 0.62114778027831 | 164.692085064579 | 126.454006643876 |  |  | 0
 |  |  | -28.5016786104724 | -78.3077183988257 | -28.5016786104724 | -78.3077183988257 | 51.6 | 4.87 | 0.62114778027831 | 100 | 150 |  |  | 0
Rotation and scale |  |  | 48.6406654620896 | -17.7037544031007 | -381.358588602281 | 138.803174833001 | 51.77 | 4.87 | 0.61881978427573 | 95.1547146362197 | 136.6876878722 |  |  | 0
Fi | -20 | ° |  |  | 78.3077183988257 | -28.5016786104724 | 51.77 | 5.35 | 0.61881978427573 | 118.502234058023 | 128.189885758712 |  |  | 0.093119840103169
s | 1.50E-07 | m |  |  |  |  | 53 | 5.35 | 0.601815023152048 | 83.4451693671418 | 31.8713921281561 |  |  | 0.7733102850505
m | 2.00E-04 | m |  |  |  |  | 52.9 | 4.8 | 0.603207987745282 | 59.5429712240397 | 49.4392288897443 |  |  | 0.104648789776008
 |  |  |  |  |  |  | 53.1 | 4.8 | 0.600420225325884 | 53.8426355019452 | 33.7776852099787 |  |  | 0.1209107372225
 |  |  |  |  |  |  |  |  |  | 53.956254429487 |  | 33.7363313023042
 |  |  |  |  |  |  |  |  |  | 76.9132364313128 |  | 16.5125250810885
 |  |  |  |  |  |  |  |  |  | 93.3310963746962 |  | 10.5369127513455
 |  |  |  |  |  |  |  |  |  | 135.375157923769 |  | 122.04864370654
 |  |  |  |  |  |  |  |  |  | 159.604340627112 |  | 113.229942401926
 |  |  |  |  |  |  |  |  |  | 164.692085064579 |  | 126.454006643877
 |  |  |  |  |  |  |  |  |  | 100 |  | 150
 |  |  |  |  |  |  |  |  |  | 95.1547146362198 |  | 136.6876878722
 |  |  |  |  |  |  |  |  |  | 118.414730031429 |  | 128.22173461977
 |  |  |  |  |  |  |  |  |  | 82.718495398702 |  | 32.1358798226843
 |  |  |  |  |  |  |  |  |  | 59.6413089195664 |  | 49.4034368956663
 |  |  |  |  |  |  |  |  |  | 53.956254429487 |  | 33.7363313023042
 |  |  |  |  |  |  |  |  |  | 100 |  |  | 150

Sheet: Refreshing_the_screen
Refreshing the screen
 | Tiles each represent a discrete amount of surface area
 | All tiles together cover the surface of the earth.
 | Each location on earth maps exactly to one tile (tiles do not overlap)
 | Each tile has a tileID, composed of a (trackRow, trackCol) pair
 | Since not all bands of tiles have equal length around the earth, tiles are only horizontally aligned
 | Tracks may represent roads on the map (subclass, other map elements possible too in future)
 | Tracks may span more than one tile
 | In order to accommodate future route planning, tracks must be broken up in pieces between intersections
 | Each track is stored in each tile it passes
 | Each track has a trackID, composed of the tileID in which the track starts, plus a serial number
Data structures in memory:
 | ActiveTileList: |  |  |  |  |  | list of tiles covering the whole screen, just the names of the tiles, and a ‘used’ flag
 | ActiveTrackList: |  |  |  |  |  | list of tracks that will be projected on the sceen. Just the track names, and a ‘used’ flag
 | Tracks: |  |  |  |  |  | all tracks, including the track ID and all data points (potentially e.g. color and width information)
Program procedure:
 | PROCESS 1:
 |  | Determine the outer bounds of the screen (red rectangle)
 |  | Determine a rectangle parallel to the tiles, surrounding the bounds of the screen (dotted red rectangle)
 |  | Create a list of all tiles (partially) on the screen
 |  |  | select all tiles that are partially in the red dotted rectangle (grey + orange rectangles)
 |  |  |  | determine the lowest and highest row: (lon, lat) => (tileRow, tileCol)
 |  |  |  | for each row, determine the first and last tile: (tileRow, lat) => (tileRow, tileCol)
 |  |  | remove all tiles from this selection that have no overlap with the actual screen (orange tiles)
 |  |  |  | overlap: any corner of rectangle is on original screen, or any corner of original screen is in rectangle
 |  | If tiles have been added or removed:
 |  |  | unflag all ‘used’ flags in the ActiveTrackList
 |  |  | go through all tiles
 |  |  |  | go through all trackIDs in the tile
 |  |  |  |  | if a track is already on the ActiveTrackList:
 |  |  |  |  |  | flag the ‘used’ flag
 |  |  |  |  | if a track is not on the ActiveTrackList:
 |  |  |  |  |  | add the track to the ActiveTrackList (with ‘used’ flag)
 |  |  |  |  |  | read track data and add to the Tracks list
 |  |  | go through ActiveTrack list
 |  |  |  | if the ‘used’ flag is not flagged:
 |  |  |  |  | Remove the track from both lists
 | PROCESS 2:
 |  | Go through all tracks in the Tracks list
 |  |  | render the track to the screen
 | Process 1 can be in a different threat running at lower priority, as long as thread safety is maintained

Sheet: Software_architecture
Central update loop | GPS | orientation
 |  | speed
 |  | simulation loop
 | Map | load and update map
 | GUI | display map

Sheet: FromCoordsToTile
Approximate numbers
Circumference of the earth | 4.00E+07 | m
Radius earth | 6.37E+06 | m | 6366.19772367581
Surface area | 5.09E+14 | m2
Average rectangle side length | 1000 | m
Average rectangle area | 1000000 | m2
Number of rectangles | 5.09E+08
Latitude | -90 | 90
Longitude | -180 | 180
Length of meridian | 20000000 | m
Number of steps along meridian | 20000 | - | 4E20
Example |  |  |  |  | 5.18 | 5.19 | 5.2 | 5.21
Latitude | 52.7 | ° |  | 52.705 | #NAME? | #NAME? | #NAME? | #NAME?
Longitude | 5.2 | ° |  | 52.7 | #NAME? | #NAME? | #NAME? | #NAME?
 |  |  |  | 52.694 | #NAME? | #NAME? | #NAME? | #NAME?
Band | 15855 | 3DEF
Beginning of band | 52.695 | °
End of band | 52.704 | °
Circumference of band | 2.42E+07 | m
Number of tiles along band | 24243 | -
Tile | 12471 | 30B7
Beginning of tile | 5.18995173864619 | °
End of tile | 5.20480138596707 | °
TileID | 3DEF-30B7

Sheet: FromTileToCoords
 |  |  |  | Band | Beginning of band | End of band | Number of tiles along band on bottom side | Number of tiles along band on top side | Number of tiles along band | Rectangle side length | Actual number of tiles | Theoretical number of tiles
TileID | 3DEE-30B8 |  |  | 0 | -90 | -89.991 | 1 | 7 | 7 | 100 | #NAME? | 5.09E+10
Band | 3DEE | 15854 |  | 1 | -89.991 | -89.982 | 7 | 13 | 13 | 146.779926762207 | #NAME? | 2.36E+10
Tile | 30B8 | 12472 |  | 2 | -89.982 | -89.973 | 13 | 19 | 19 | 215.443469003188 | #NAME? | 1.10E+10
Radius earth | 6.37E+06 | m |  | 3 | -89.973 | -89.964 | 19 | 26 | 26 | 316.227766016838 | #NAME? | 5.09E+09
Length of meridian | 20000000 | m |  | 4 | -89.964 | -89.955 | 26 | 32 | 32 | 464.158883361278 | #NAME? | 2.36E+09
Average rectangle side length | 1000 | m |  | 5 | -89.955 | -89.946 | 32 | 38 | 38 | 681.292069057961 | #NAME? | 1.10E+09
Number of bands along meridian | 20000 | - |  | 6 | -89.946 | -89.937 | 38 | 44 | 44 | 1000 | #NAME? | 5.09E+08
Band is between | 52.6860000000001 | 52.6950000000001 | ° | 7 | -89.937 | -89.928 | 44 | 51 | 51 | 1467.79926762207 | #NAME? | 2.36E+08
Number of tiles along band on bottom side | 24248 | - |  | 8 | -89.928 | -89.919 | 51 | 57 | 57 | 2154.43469003188 | #NAME? | 1.10E+08
Number of tiles along band on top side | 24243 | - |  | 9 | -89.919 | -89.91 | 57 | 63 | 63 | 3162.27766016838 | #NAME? | 5.09E+07
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
 |  |  |  | 1634 | -75.294 | -75.285 | 10155 | 10161 | 10161
 |  |  |  | 1635 | -75.285 | -75.276 | 10161 | 10167 | 10167
 |  |  |  | 1636 | -75.276 | -75.267 | 10167 | 10173 | 10173
 |  |  |  | 1637 | -75.267 | -75.258 | 10173 | 10179 | 10179
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
