henkjannl/GPS/06 Mechanical/RC/GPS top.stl

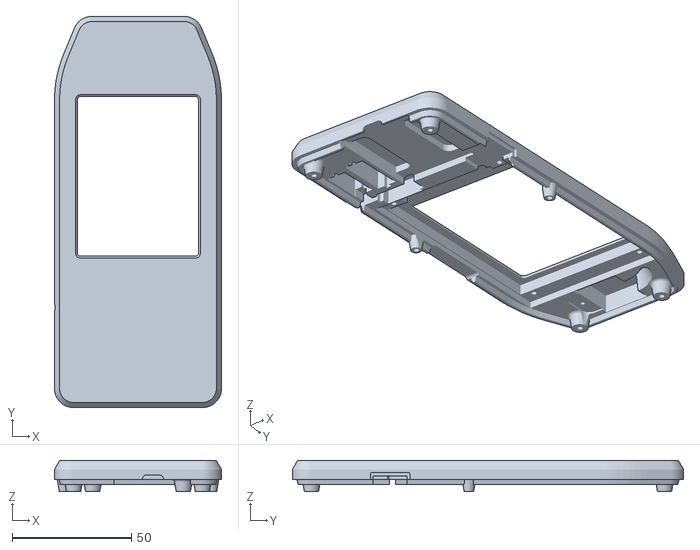
[picture p25: CAD file, 2021-02-27]
06 Mechanical/RC/GPS top.stl
70.0 x 164.0 x 13.0
