henkjannl/GPS/06 Mechanical/RC/Close stacking of components.FCStd

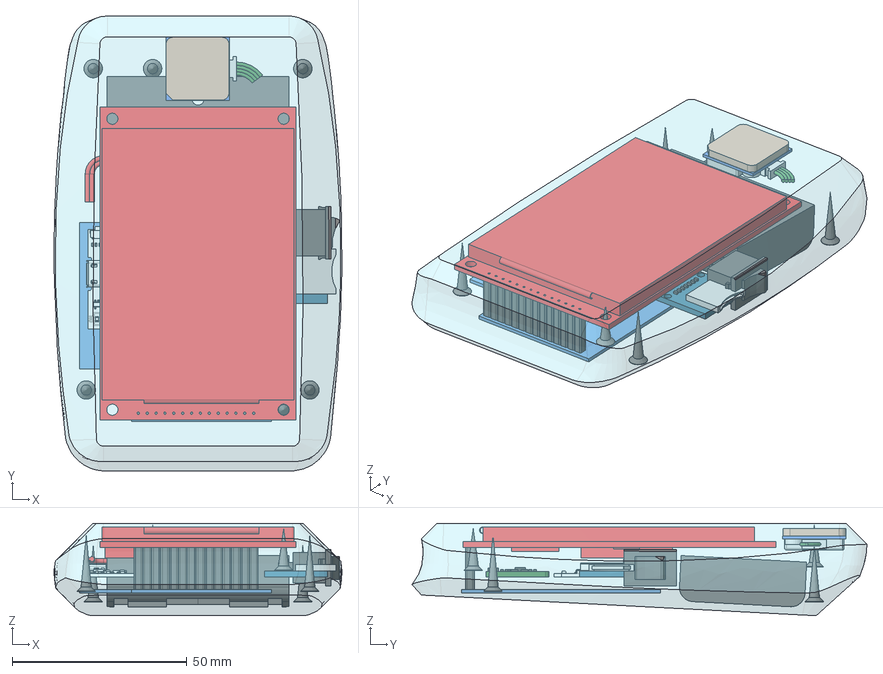
[picture p26: CAD file, 2021-02-27]
06 Mechanical/RC/Close stacking of components.FCStd
82.4 x 130.3 x 26.5 mm
PCB001
Antenna
Module
Connector-F
Battery
Connector-M
Cable
MH-ET_LIVE_MiniKit
PCB002
Resistor1
BMI160
Resistor002
Resistor003
Resistor004
Resistor005
Resistor006
Resistor007
Resistor008
Resistor009
Slot
PCB003
Components
Housing
Wires
Switch rocker KCD1-11
SelftappingScrew3.0x16 fl
SelftappingScrew3.0x16 fr
SelftappingScrew3.0x16 rr
SelftappingScrew3.0x16 rl
SelftappingScrew3.0x12 screen rear
SelftappingScrew3.0x12 gps
MB PCB
MB Pin header
HT Housing top
Screen 3.2"
