henkjannl/GPS/06 Mechanical/RC/GPS bottom.stl

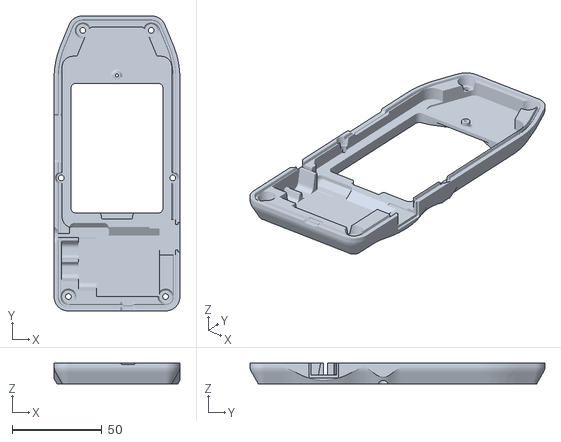
[picture p27: CAD file, 2021-02-27]
06 Mechanical/RC/GPS bottom.stl
70.0 x 164.0 x 11.5
