henkjannl/GPS/06 Mechanical/RC/GPS Screen mount.stl

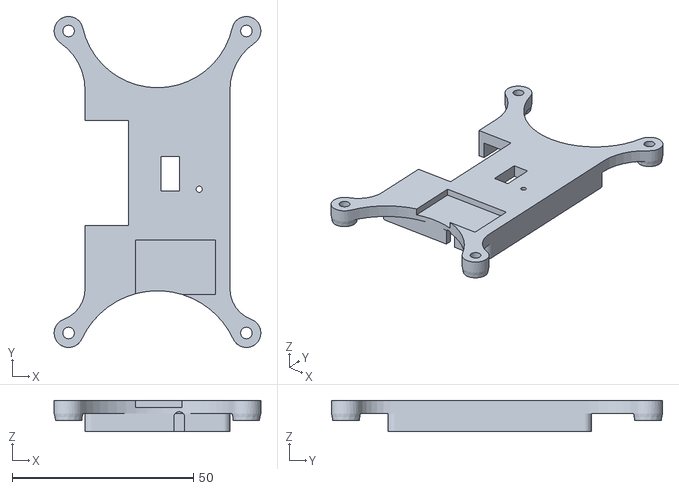
[picture p28: CAD file, 2021-02-27]
06 Mechanical/RC/GPS Screen mount.stl
57.0 x 91.3 x 8.60
