henkjannl/GPS/06 Mechanical/RC/Switch rocker KCD1-11.FCStd

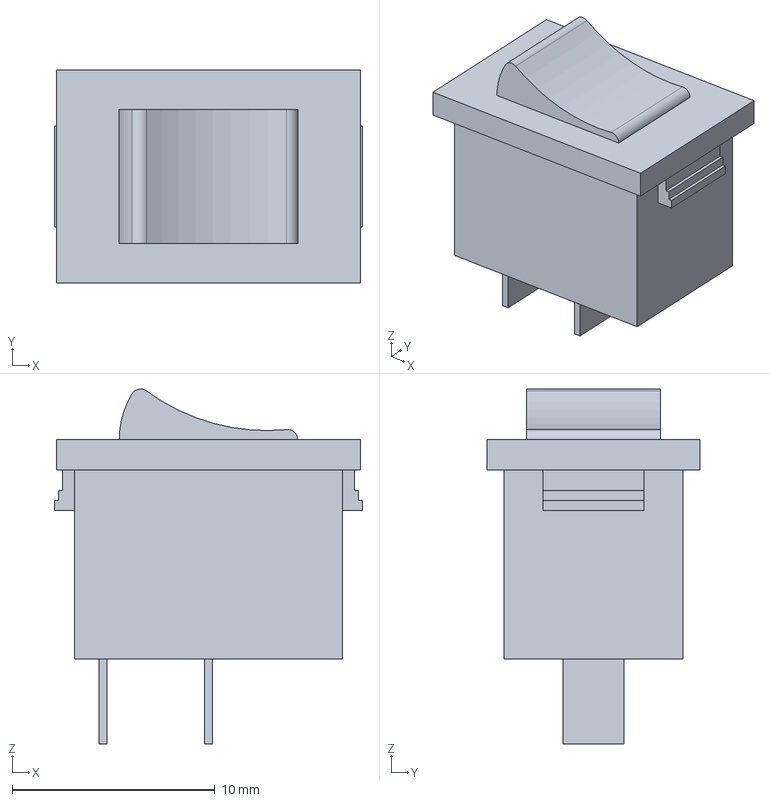
[picture p29: CAD file, 2021-02-27]
06 Mechanical/RC/Switch rocker KCD1-11.FCStd
15.2 x 10.5 x 17.5 mm
