henkjannl/GPS/06 Mechanical/RC/esp32-mh-et-live-minikit-d1.FCStd

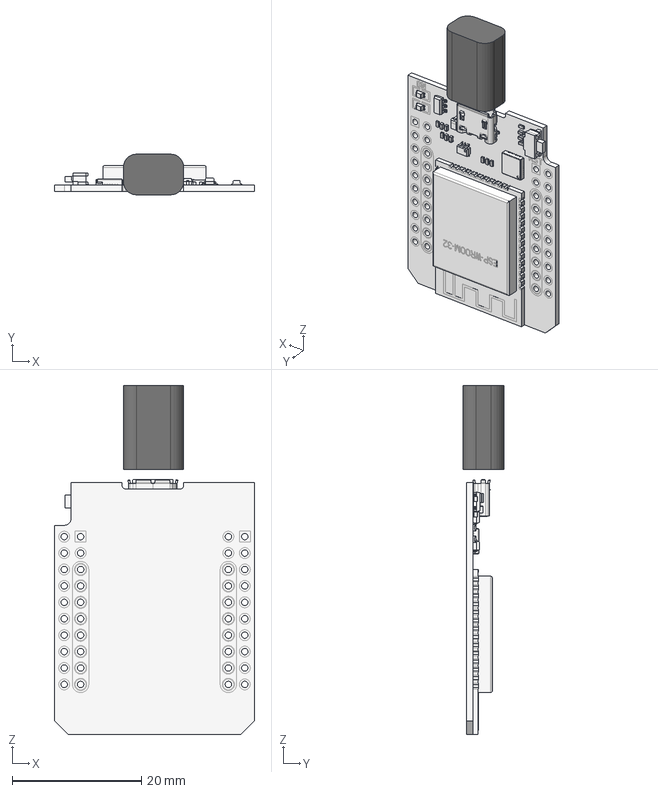
[picture p30: CAD file, 2021-02-27]
06 Mechanical/RC/esp32-mh-et-live-minikit-d1.FCStd
31.0 x 6.30 x 54.0 mm
MH-ET_LIVE_MiniKit
