henkjannl/GPS/06 Mechanical/RC/SD Card.FCStd

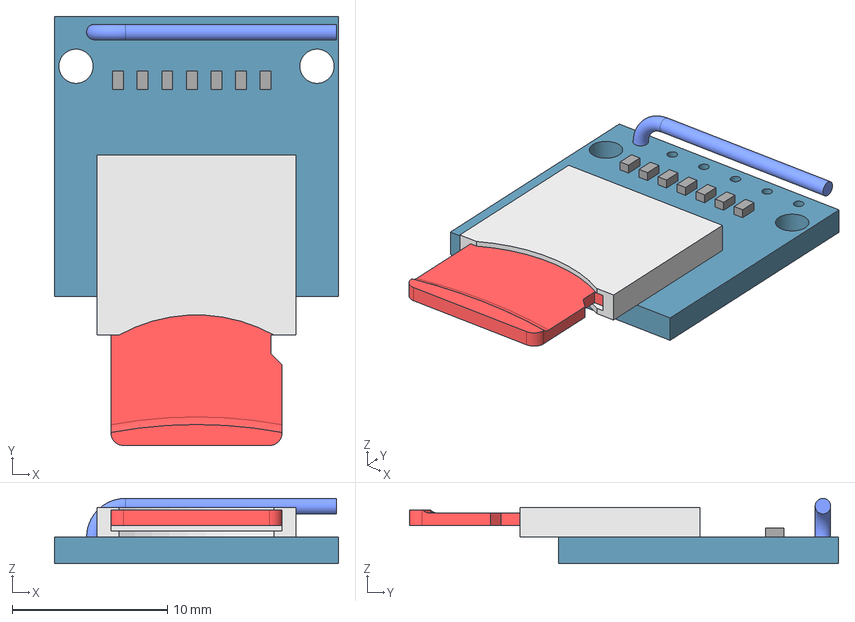
[picture p31: CAD file, 2021-02-27]
06 Mechanical/RC/SD Card.FCStd
18.3 x 27.6 x 4.20 mm
Slot
PCB
Components
Wire
SD Card
