henkjannl/GPS/06 Mechanical/RC/Beitian BN-180 GPS.FCStd

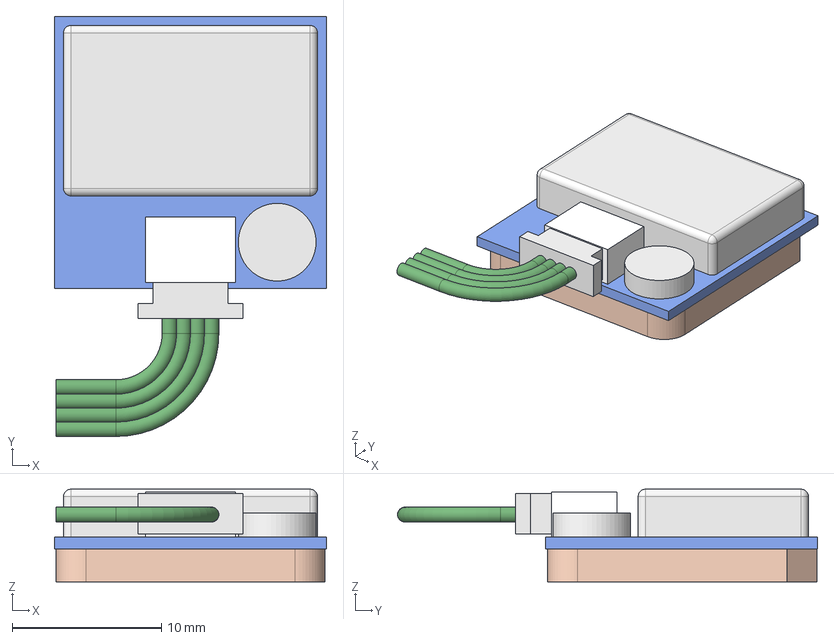
[picture p32: CAD file, 2021-02-27]
06 Mechanical/RC/Beitian BN-180 GPS.FCStd
18.2 x 28.1 x 6.20 mm
PCB
Antenna
Module
Connector-F
Battery
Connector-M
Cable
