henkjannl/GPS/06 Mechanical/RC/GPS Battery door.stl

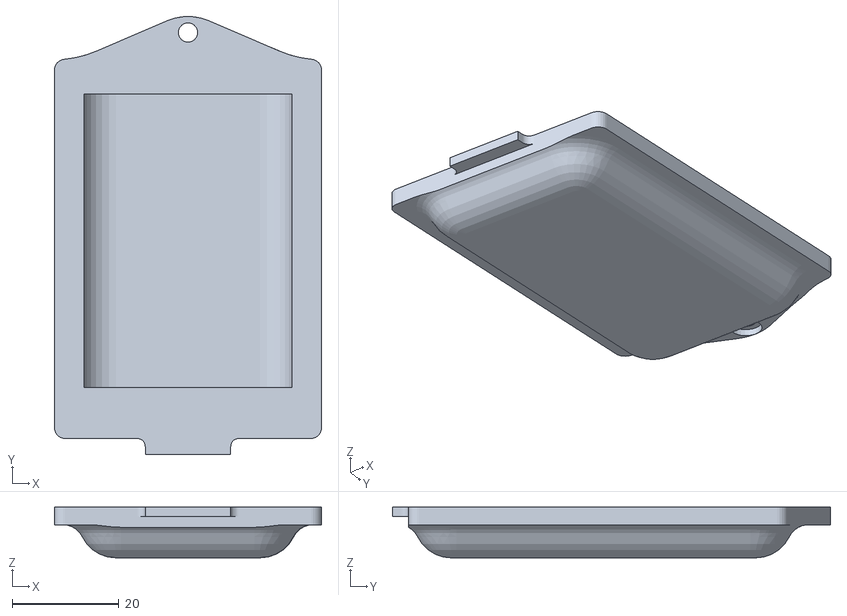
[picture p33: CAD file, 2021-02-27]
06 Mechanical/RC/GPS Battery door.stl
50.0 x 82.0 x 9.50
