henkjannl/GPS/06 Mechanical/RC/GPS mount.stl

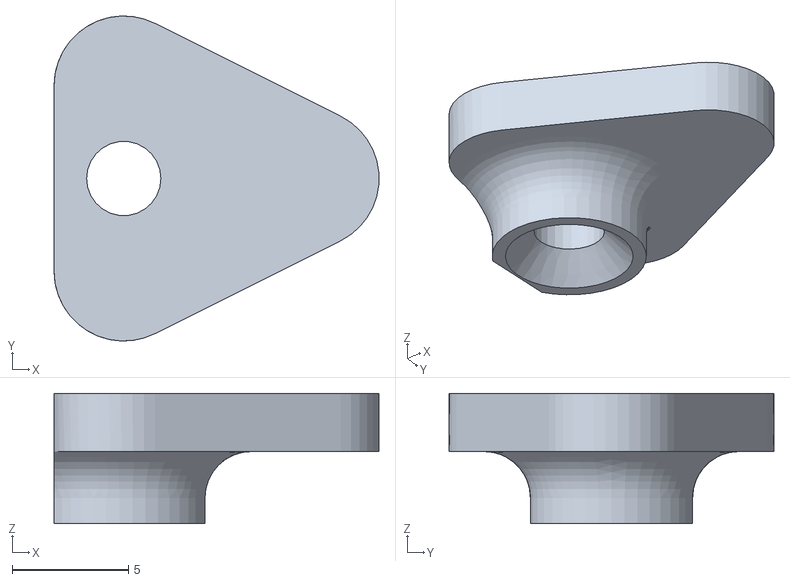
[picture p34: CAD file, 2021-02-27]
06 Mechanical/RC/GPS mount.stl
14.0 x 14.0 x 5.60
