henkjannl/GPS/06 Mechanical/RC/Battery 3xAAA.FCStd

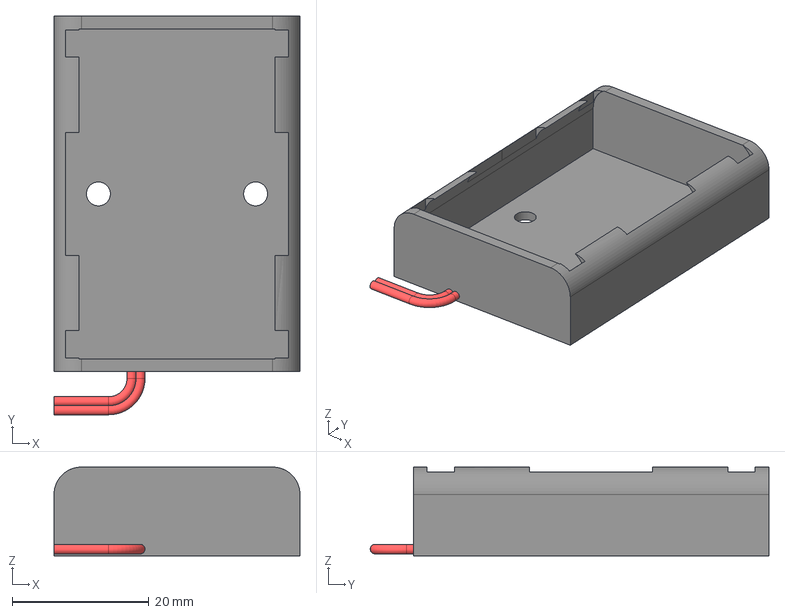
[picture p35: CAD file, 2021-02-27]
06 Mechanical/RC/Battery 3xAAA.FCStd
36.0 x 58.3 x 13.0 mm
Housing
Wires
