henkjannl/GPS/06 Mechanical/RC/BMI160 accelerometer.FCStd

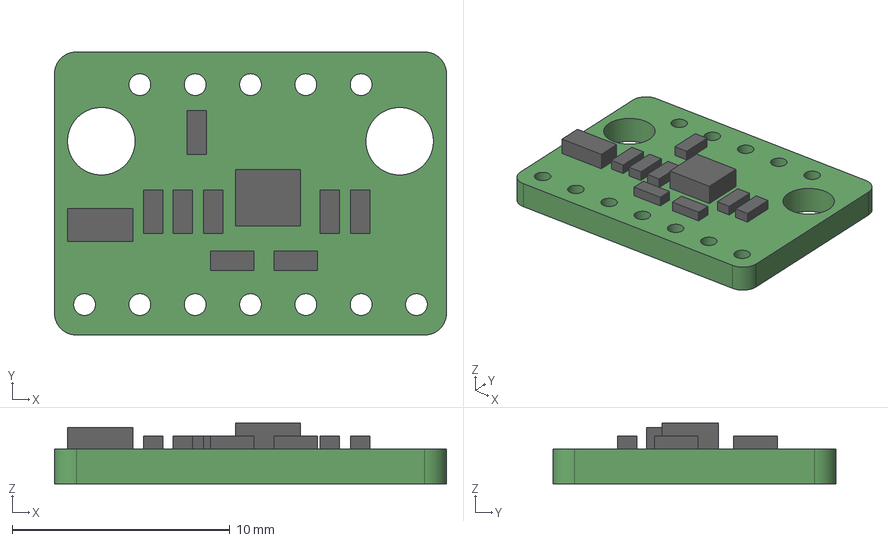
[picture p36: CAD file, 2021-02-27]
06 Mechanical/RC/BMI160 accelerometer.FCStd
18.0 x 13.0 x 2.80 mm
PCB
Resistor1
BMI160
Resistor002
Resistor003
Resistor004
Resistor005
Resistor006
Resistor007
Resistor008
Resistor009
