henkjannl/GPS/06 Mechanical/RC/Display 3.2'' 320x240.FCStd

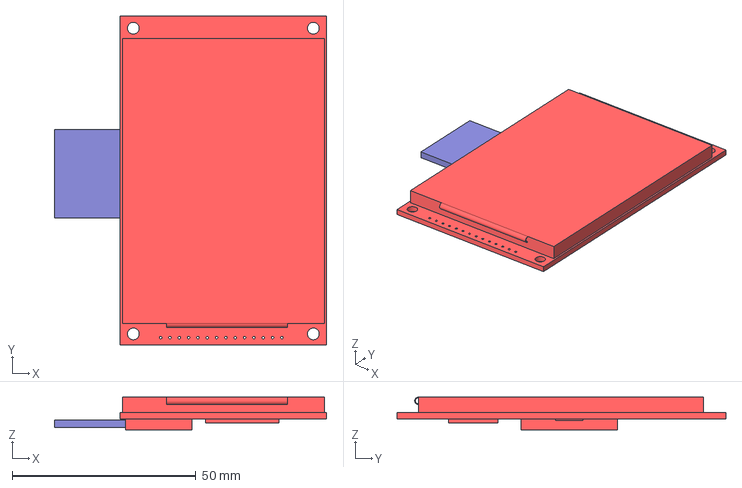
[picture p37: CAD file, 2021-02-27]
06 Mechanical/RC/Display 3.2'' 320x240.FCStd
74.1 x 89.6 x 8.90 mm
Screen
SD Card
