henkjannl/GPS/06 Mechanical/RC/Trial new housing.stl

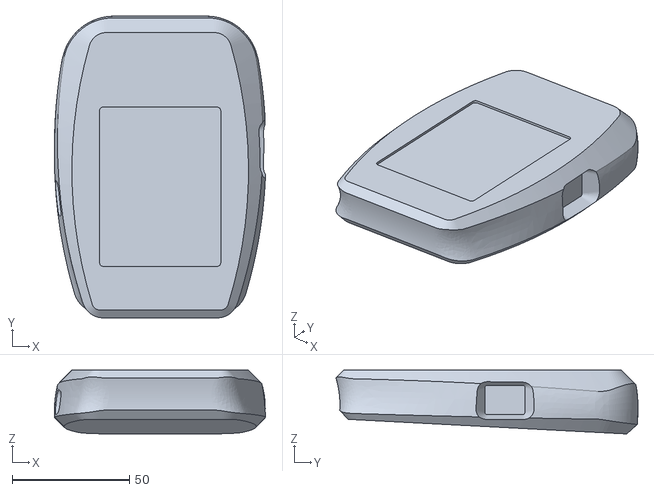
[picture p38: CAD file, 2021-02-27]
06 Mechanical/RC/Trial new housing.stl
90.0 x 128.6 x 27.2
