henkjannl/GPS/06 Mechanical/RC/SelftappingScrewM2.3x12.FCStd

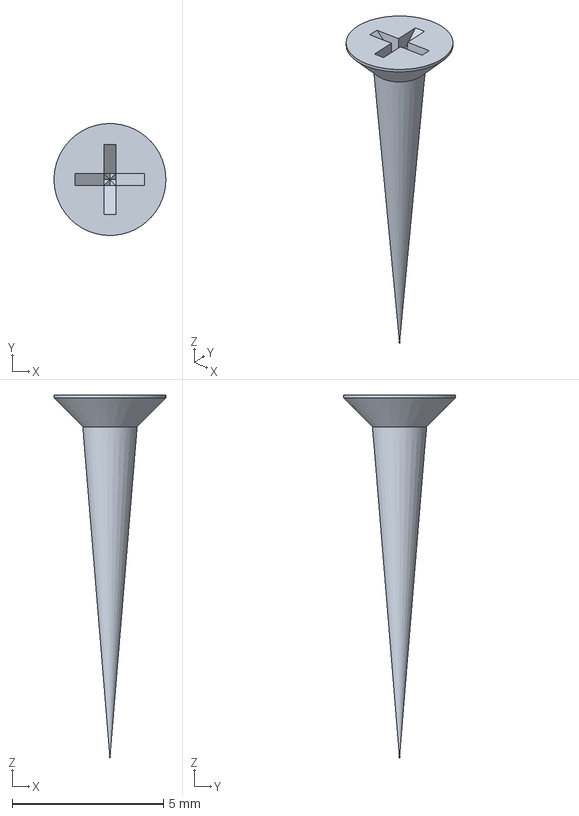
[picture p39: CAD file, 2021-02-27]
06 Mechanical/RC/SelftappingScrewM2.3x12.FCStd
3.70 x 3.70 x 12.0 mm
