henkjannl/GPS/06 Mechanical/RC/SelftappingScrew3.0x16.FCStd

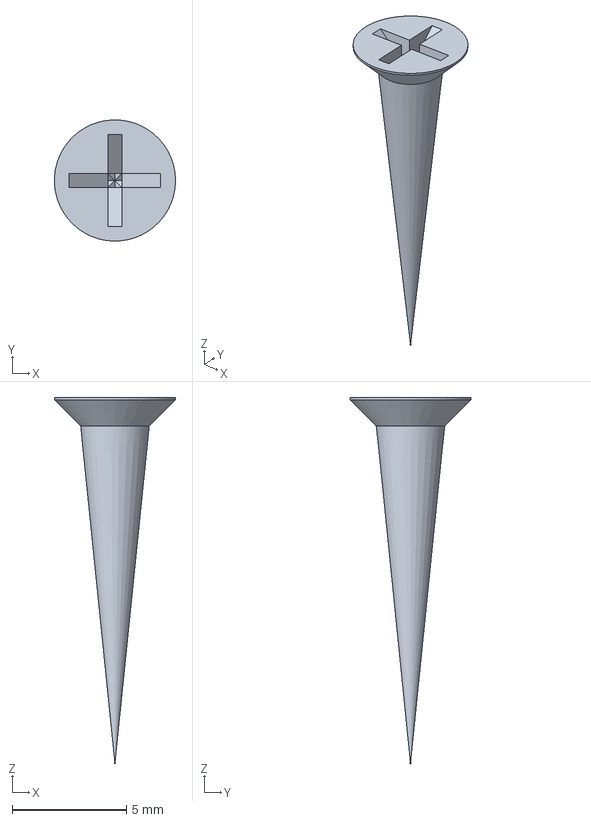
[picture p40: CAD file, 2021-02-27]
06 Mechanical/RC/SelftappingScrew3.0x16.FCStd
5.29 x 5.30 x 16.0 mm
