henkjannl/GPS/09 Readonly/2020-12-30 Wiring photo's/3D Model - 700.jpg

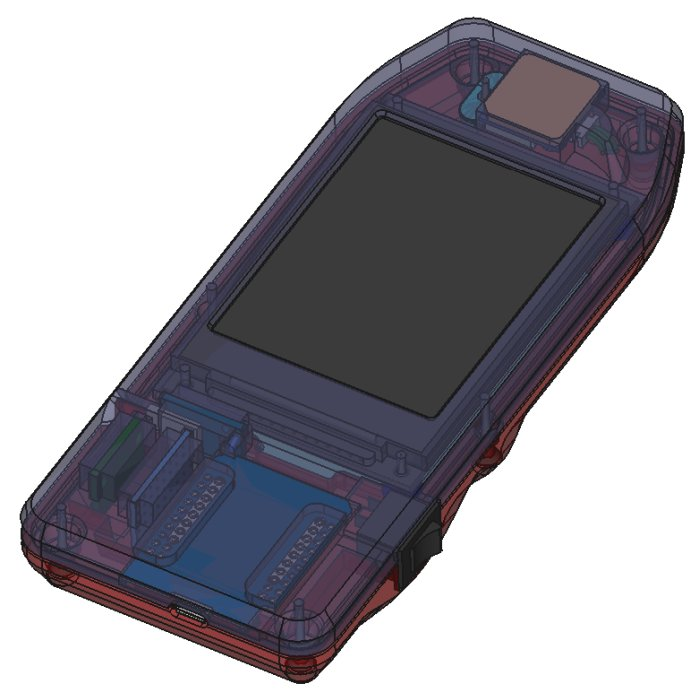
09 Readonly/2020-12-30 Wiring photo's/3D Model - 700.jpg
