henkjannl/GPS/09 Readonly/2020-12-30 Wiring photo's/Device open - 700.jpg

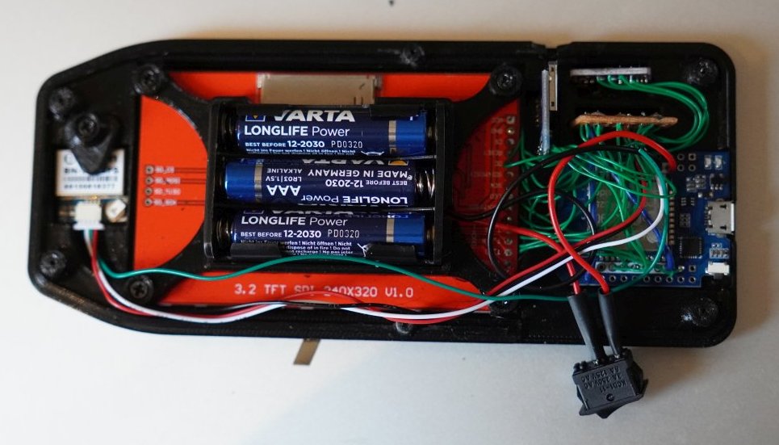
09 Readonly/2020-12-30 Wiring photo's/Device open - 700.jpg
