henkjannl/GPS/09 Readonly/2020-12-30 Wiring photo's/Device workin.png

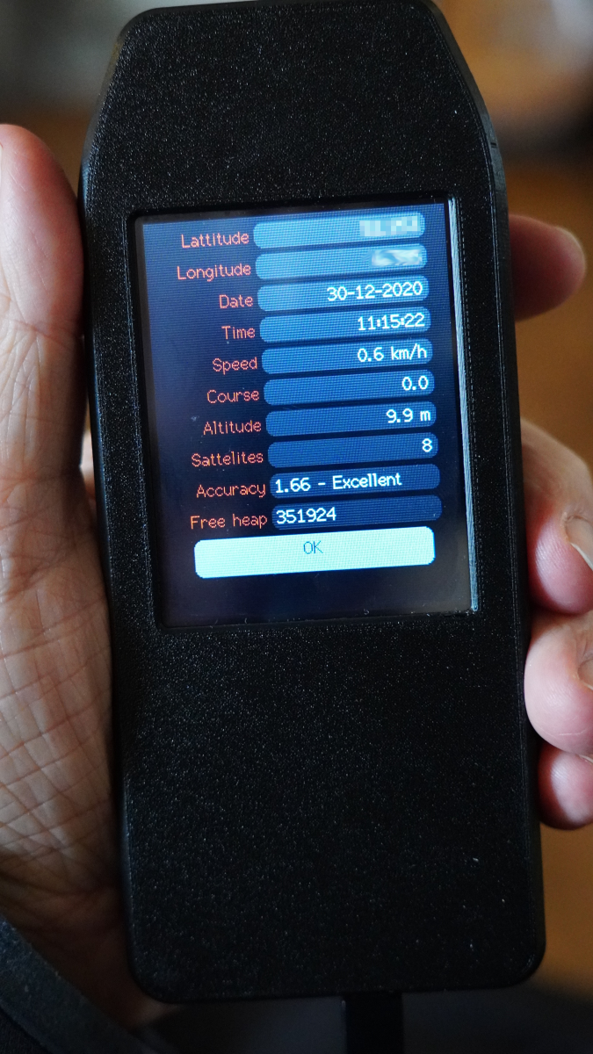
09 Readonly/2020-12-30 Wiring photo's/Device workin.png
