henkjannl/GPS/02 System/ContrastTest/ContrastTest.png

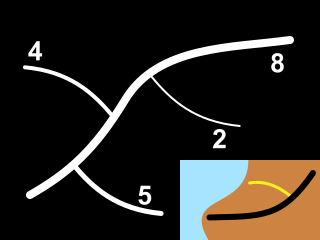
02 System/ContrastTest/ContrastTest.png
