henkjannl/GPS/05 Electrical/Wiring diagram 07 - MH-ET Live Minikit.pdf

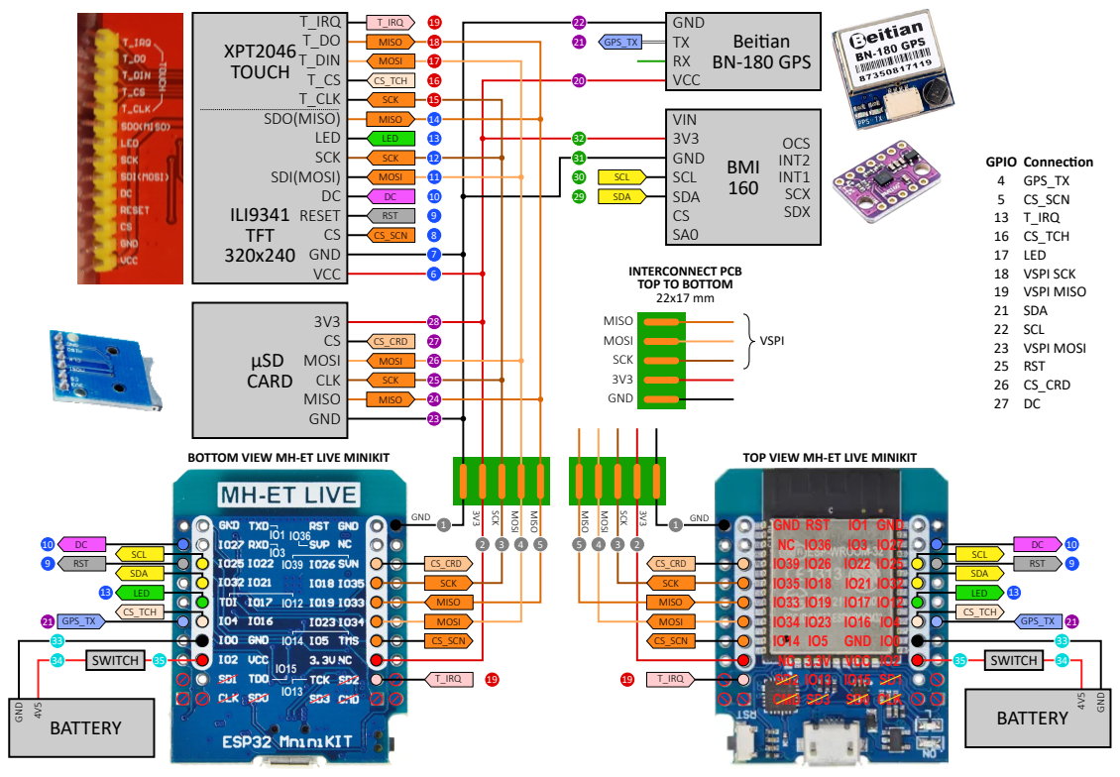
[picture p46: page 1]
CMD; CLKSD0SD3; GND RST; GND; IO0GND; NC 3.3V VCC IO2; T_IRQ; T_DO T_DIN T_CS T_CLK SDO(MISO) LED SCK SDI(MOSI) DC RESET CS GND VCC; XPT2046 TOUCH; ILI9341 TFT 320x240; CS_TCH; MOSI; MISO; SCK; GPS_TX; VCC; µSD CARD; CS_CRD; MOSI CLK MISO; LED; RST; BATTERY; SWITCH; SCL; SDA; GND TX RX VCC; Beian BN-180 GPS; VSPI; GPIO Connecon; CS_SCN; 13 T_IRQ 16 CS_TCH 17 LED 18 VSPI SCK 19 21 SDA 22 SCL 23 25 RST 26 CS_CRD 27 DC; VSPI MISO; VSPI MOSI; BOTTOM VIEW MH-ET LIVE MINIKIT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

MISO | 14
LED | 13

VIN 3V3 GND | OCS INT2 BMI INT1 160 SCX SDX

DC RST CS_SCN | 9 8 7 | SCL SDA CS SA0

INTERCONNECT PCB
TOP TO BOTTOM

SCK | 25
MISO | 24

GND 1

GND

2 | | 5 4 | 3 | 2 | CS_CRD SCK

MOSI

CS_SCN | CS_SCN
