henkjannl/GPS/05 Electrical/ArduiTouch_Schematic_V01-01.pdf

## TxD

## TxD

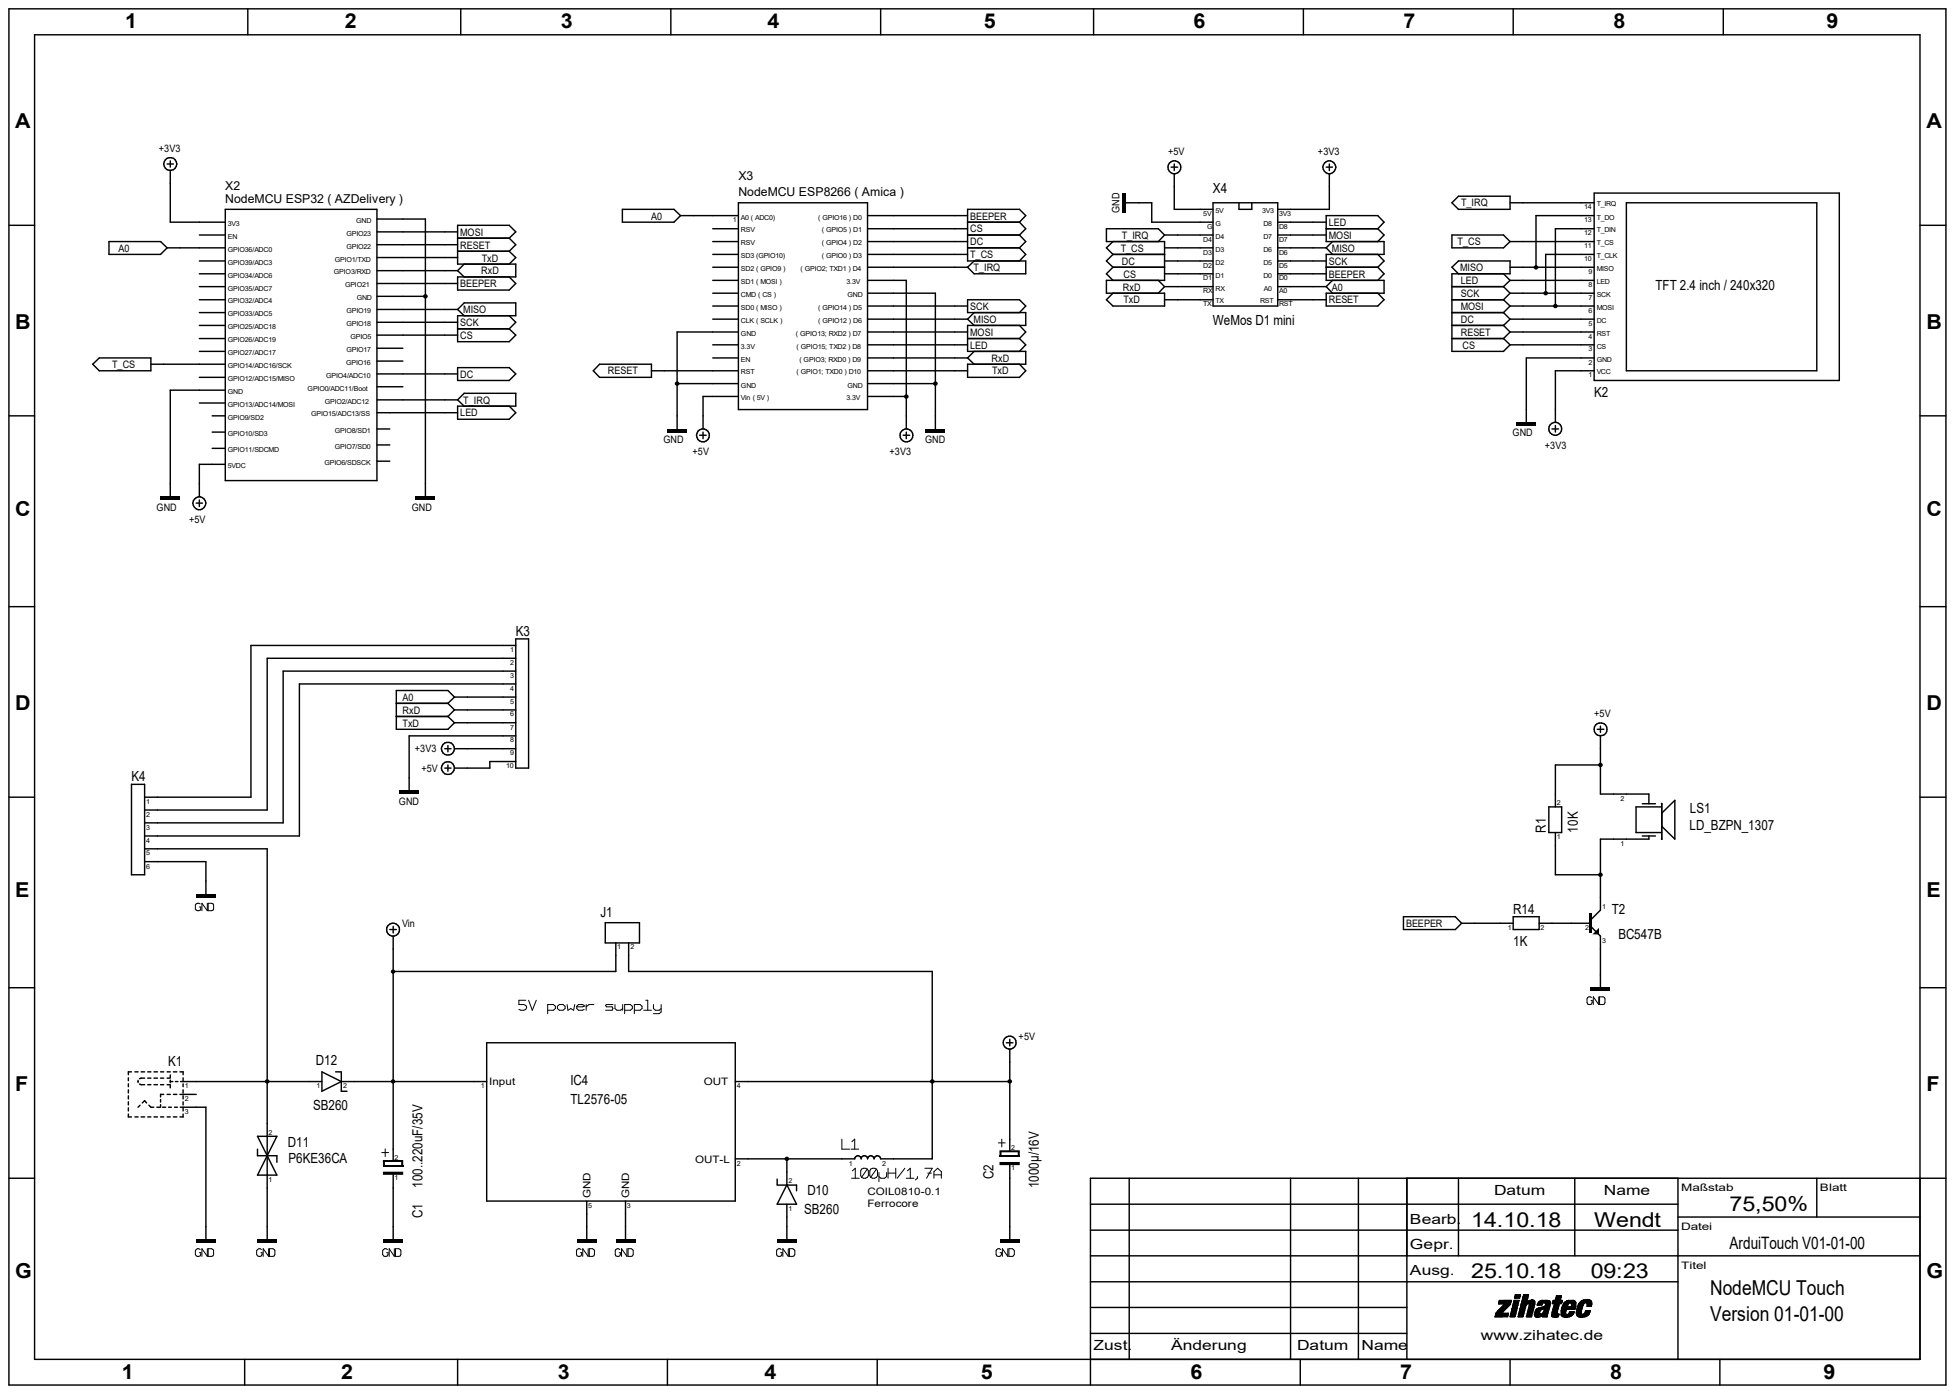
[picture p47: page 1]

1 A0 ( ADC0) NodeMCU ESP8266 ( Amica ) X3
CLK ( SCLK ) SD0 ( MISO ) CMD ( CS ) SD1 ( MOSI ) SD2 ( GPIO9 ) SD3 (GPIO10) RSV RSV
