henkjannl/GPS/07 Software/_Feasibility/2020-12-25b SD Card - different library/src/main.cpp

/*
  SD card read/write
 
 This example shows how to read and write data to and from an SD card file 	
 The circuit:
 * SD card attached to SPI bus as follows:
 ** UNO:  MOSI - pin 11, MISO - pin 12, CLK - pin 13, CS - pin 4 (CS pin can be changed)
  and pin #10 (SS) must be an output
 ** Mega:  MOSI - pin 51, MISO - pin 50, CLK - pin 52, CS - pin 4 (CS pin can be changed)
  and pin #52 (SS) must be an output
 ** Leonardo: Connect to hardware SPI via the ICSP header

 
 created   Nov 2010  by David A. Mellis
 modified 9 Apr 2012  by Tom Igoe
 
 This example code is in the public domain.
 	 
 */
 
#include <SPI.h>
#include <mySD.h>

File myFile;

// change this to match your SD shield or module;
//     Arduino Ethernet shield: pin 4
//     Adafruit SD shields and modules: pin 10
//     Sparkfun SD shield: pin 8
const int chipSelect = 4;

void setup()
{
 // Open serial communications and wait for port to open:
  Serial.begin(115200);
   while (!Serial) {
    ; // wait for serial port to connect. Needed for Leonardo only
  }


  Serial.print("Initializing SD card...");
  // On the Ethernet Shield, CS is pin 4. It's set as an output by default.
  // Note that even if it's not used as the CS pin, the hardware SS pin 
  // (10 on most Arduino boards, 53 on the Mega) must be left as an output 
  // or the SD library functions will not work. 
  pinMode(SS, OUTPUT);

  int attempts=0;

  while (!SD.begin(26, 23, 19, 18)) {
    // begin(uint8_t csPin = SD_CHIP_SELECT_PIN, int8_t mosi = -1, int8_t miso = -1, int8_t sck = -1);
    attempts++;
    delay(100);
  }
  Serial.printf("initialization succesful after %d attempts\n.", attempts);
  
  // open the file. note that only one file can be open at a time,
  // so you have to close this one before opening another.
  myFile = SD.open("test.txt", FILE_WRITE);
  
  // if the file opened okay, write to it:
  if (myFile) {
    Serial.print("Writing to test.txt...");
    myFile.println("testing 1, 2, 3.");
	// close the file:
    myFile.close();
    Serial.println("done.");
  } else {
    // if the file didn't open, print an error:
    Serial.println("error opening test.txt");
  }
  
  // re-open the file for reading:
  myFile = SD.open("test.txt");
  if (myFile) {
    Serial.println("test.txt:");
    
    // read from the file until there's nothing else in it:
    while (myFile.available()) {
    	Serial.write(myFile.read());
    }
    // close the file:
    myFile.close();
  } else {
  	// if the file didn't open, print an error:
    Serial.println("error opening test.txt");
  }
}

void loop()
{
	// nothing happens after setup
}
